greenenergyprojects/rpi-atmega324-modbus-x3-gateway/kicad/dist/rpi-atmega324-modbus-x3-gateway_image-bottom.png

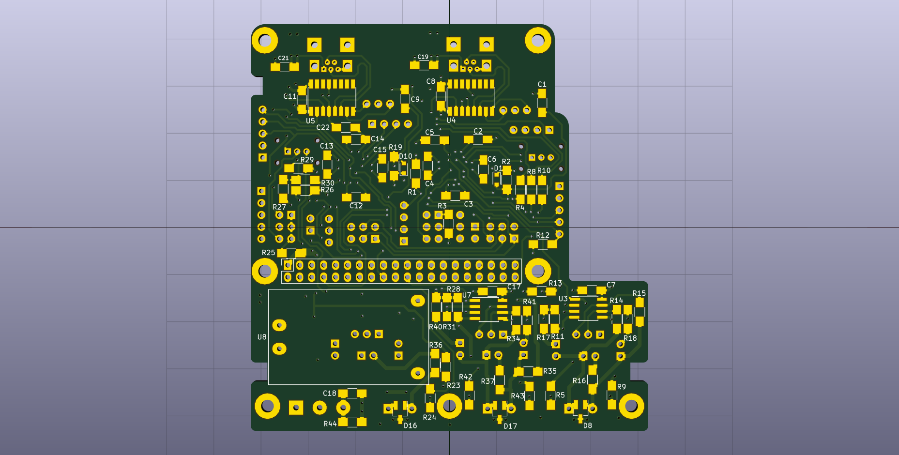
kicad/dist/rpi-atmega324-modbus-x3-gateway_image-bottom.png
