greenenergyprojects/rpi-atmega324-modbus-x3-gateway/kicad/dist/rpi-atmega324-modbus-x3-gateway_image-top.png

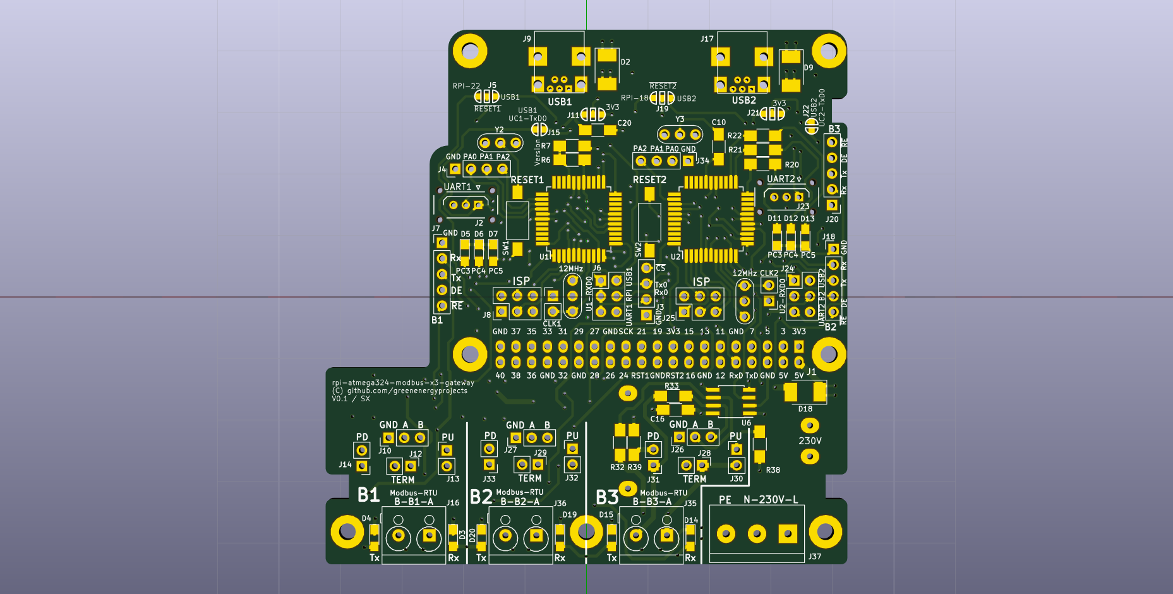
kicad/dist/rpi-atmega324-modbus-x3-gateway_image-top.png
