greenenergyprojects/rpi-atmega324-modbus-x3-gateway/kicad/dist/rpi-atmega324-modbus-x3-gateway_bom.ods

Source: | /work/sx/gep/rpi-atmega324-modbus-x3-gateway/kicad/rpi-atmega324-modbus-x3-gateway.sch
Date: | Do 20 Sep 2018 05:27:58 CEST
Tool: | Eeschema 4.0.7-e2-6376~61~ubuntu18.04.1
Component Count: | 139
Ref | Value | Footprint | Datasheet | Manufacturer | Vendor
C1 | 100n | Capacitors_SMD:C_1206_HandSoldering
C2 | 100n | Capacitors_SMD:C_1206_HandSoldering
C3 | 100n | Capacitors_SMD:C_1206_HandSoldering
C4 | 100n | Capacitors_SMD:C_1206_HandSoldering
C5 | 100n | Capacitors_SMD:C_1206_HandSoldering
C6 | 100n | Capacitors_SMD:C_1206_HandSoldering
C7 | 100n | Capacitors_SMD:C_1206_HandSoldering
C8 | 100n | Capacitors_SMD:C_1206_HandSoldering
C9 | 100n | Capacitors_SMD:C_1206_HandSoldering
C10 | 100n | Capacitors_SMD:C_1206_HandSoldering
C11 | 100n | Capacitors_SMD:C_1206_HandSoldering
C12 | 100n | Capacitors_SMD:C_1206_HandSoldering
C13 | 100n | Capacitors_SMD:C_1206_HandSoldering
C14 | 100n | Capacitors_SMD:C_1206_HandSoldering
C15 | 100n | Capacitors_SMD:C_1206_HandSoldering
C16 | 100n | Capacitors_SMD:C_1206_HandSoldering
C17 | 100n | Capacitors_SMD:C_1206_HandSoldering
C18 | 100n | Capacitors_SMD:C_1206_HandSoldering
C19 | 100n | Capacitors_SMD:C_1206_HandSoldering
C20 | 100n | Capacitors_SMD:C_1206_HandSoldering
C21 | 100n | Capacitors_SMD:C_1206_HandSoldering
C22 | 100n | Capacitors_SMD:C_1206_HandSoldering
D1 | D_Schottky | Diodes_SMD:D_0805
D2 | D_Schottky | Diodes_SMD:D_2114
D3 | LED | LEDs:LED_0805_HandSoldering
D4 | LED | LEDs:LED_0805_HandSoldering
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
U8 | HLK-5M05 | Project:HLK_5M05
Y1 | 12MHz | Crystals:Resonator-3pin_w7.0mm_h2.5mm
Y2 | 12MHz | Crystals:Resonator-3pin_w7.0mm_h2.5mm
Y3 | 12MHz | Crystals:Resonator-3pin_w7.0mm_h2.5mm
Y4 | 12MHz | Crystals:Resonator-3pin_w7.0mm_h2.5mm
