greenenergyprojects/rpi-atmega324-modbus-x3-gateway/kicad/dist/rpi-atmega324-modbus-x3-gateway_bom_pcb.pdf

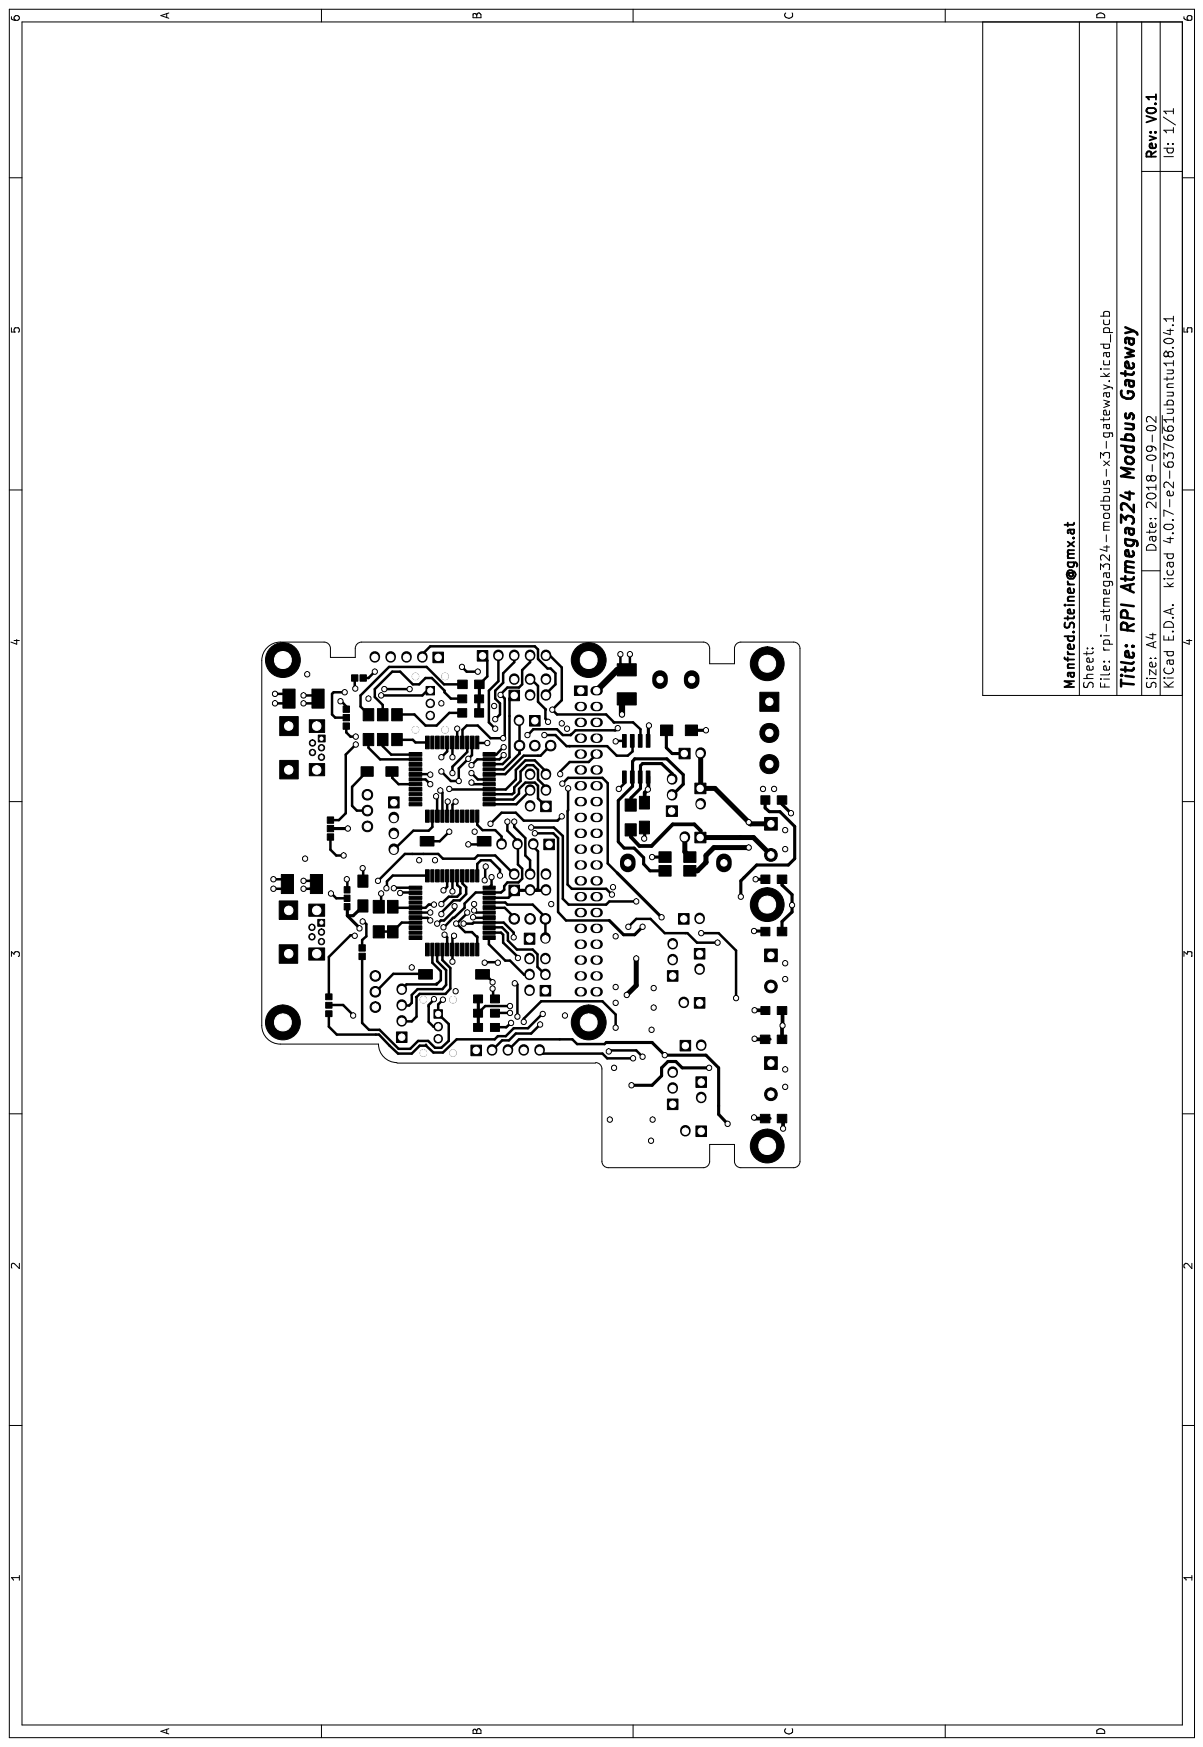
[picture p3: page 1]

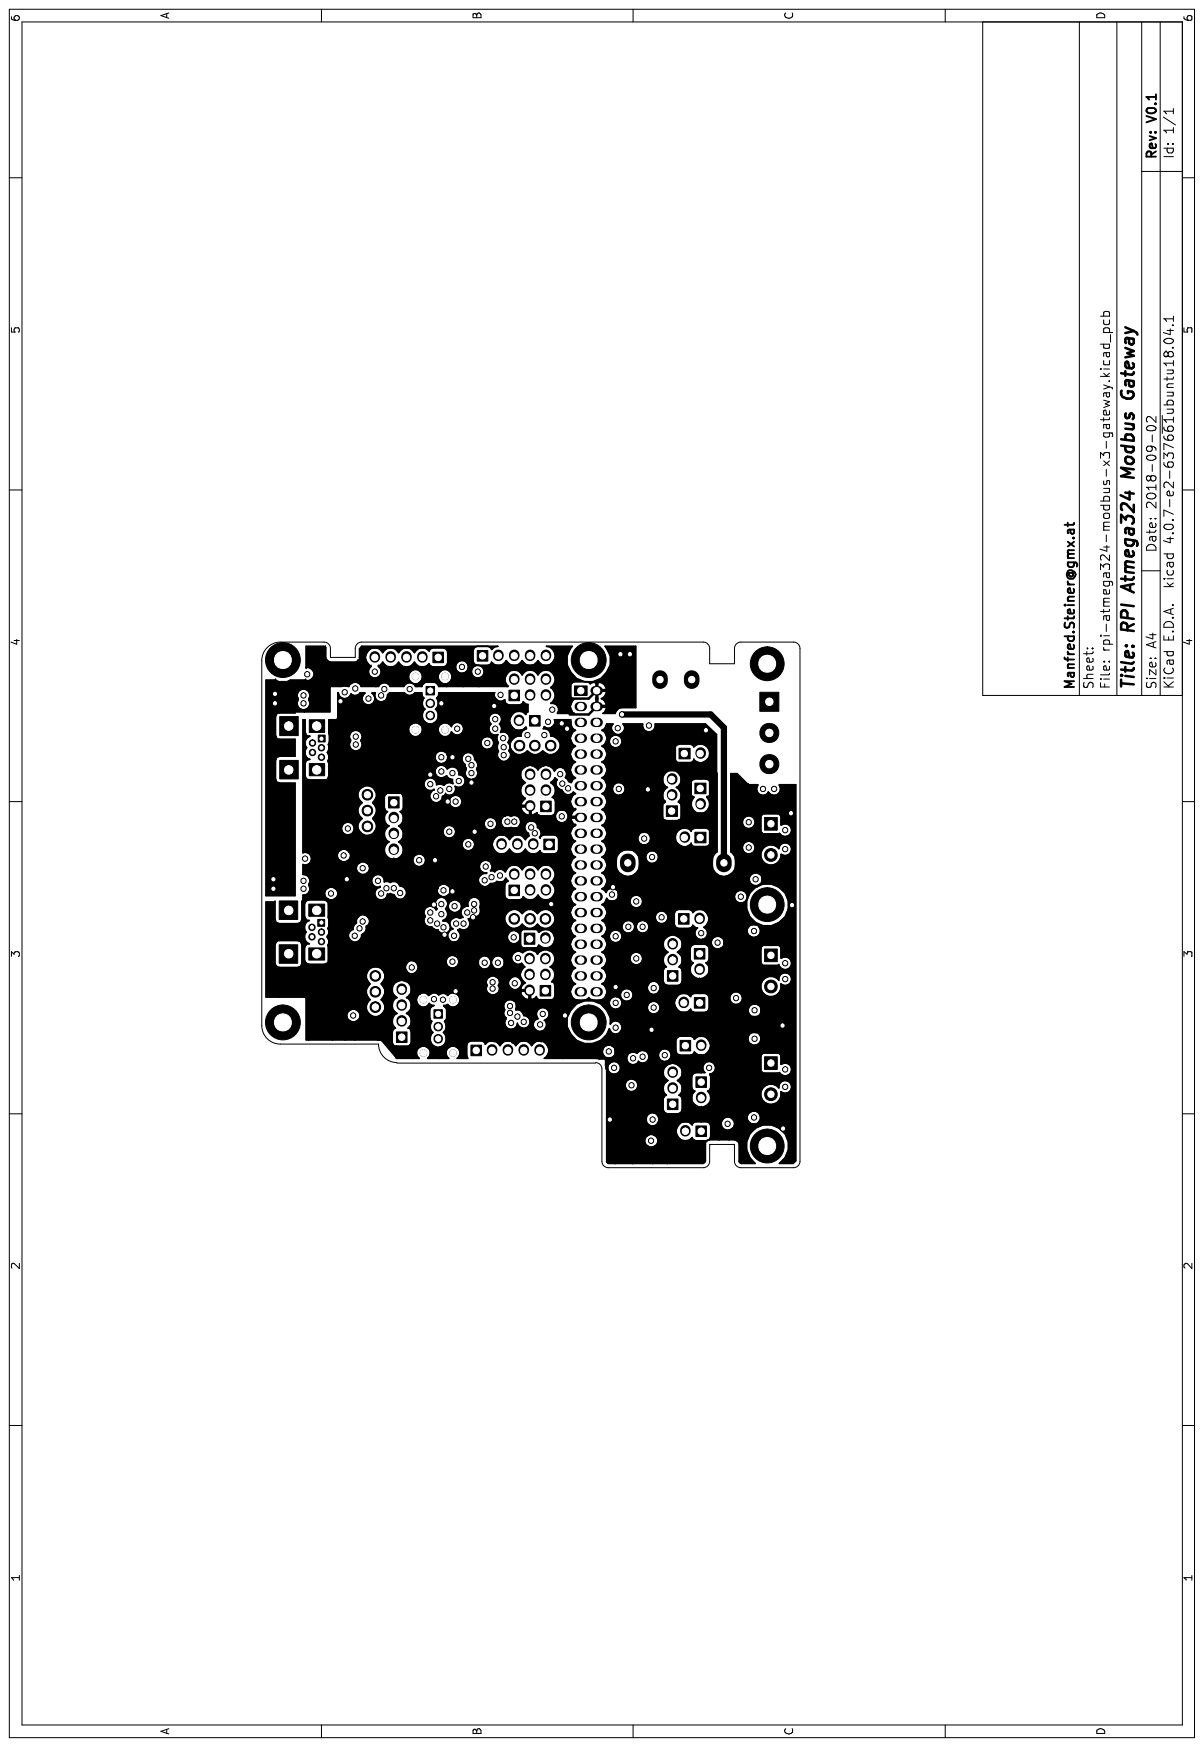
[picture p4: page 2]

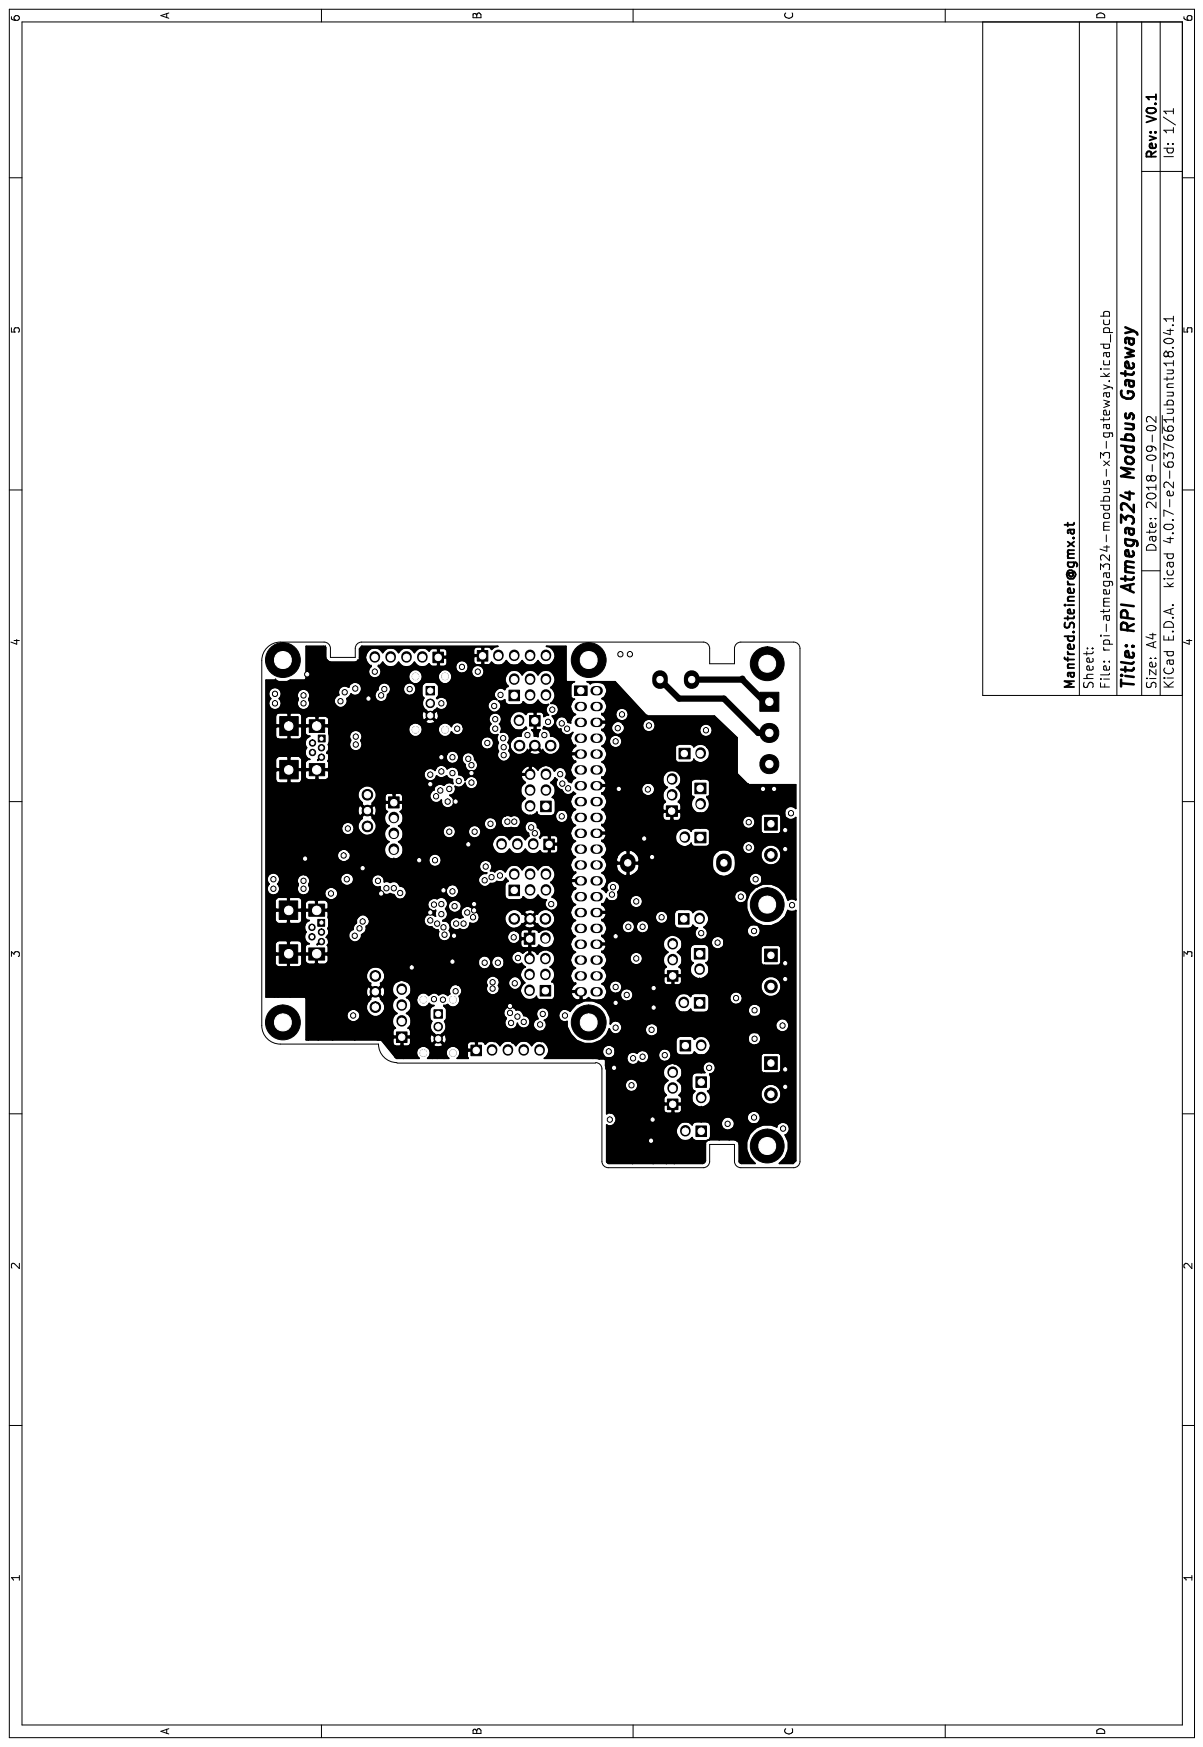
[picture p5: page 3]

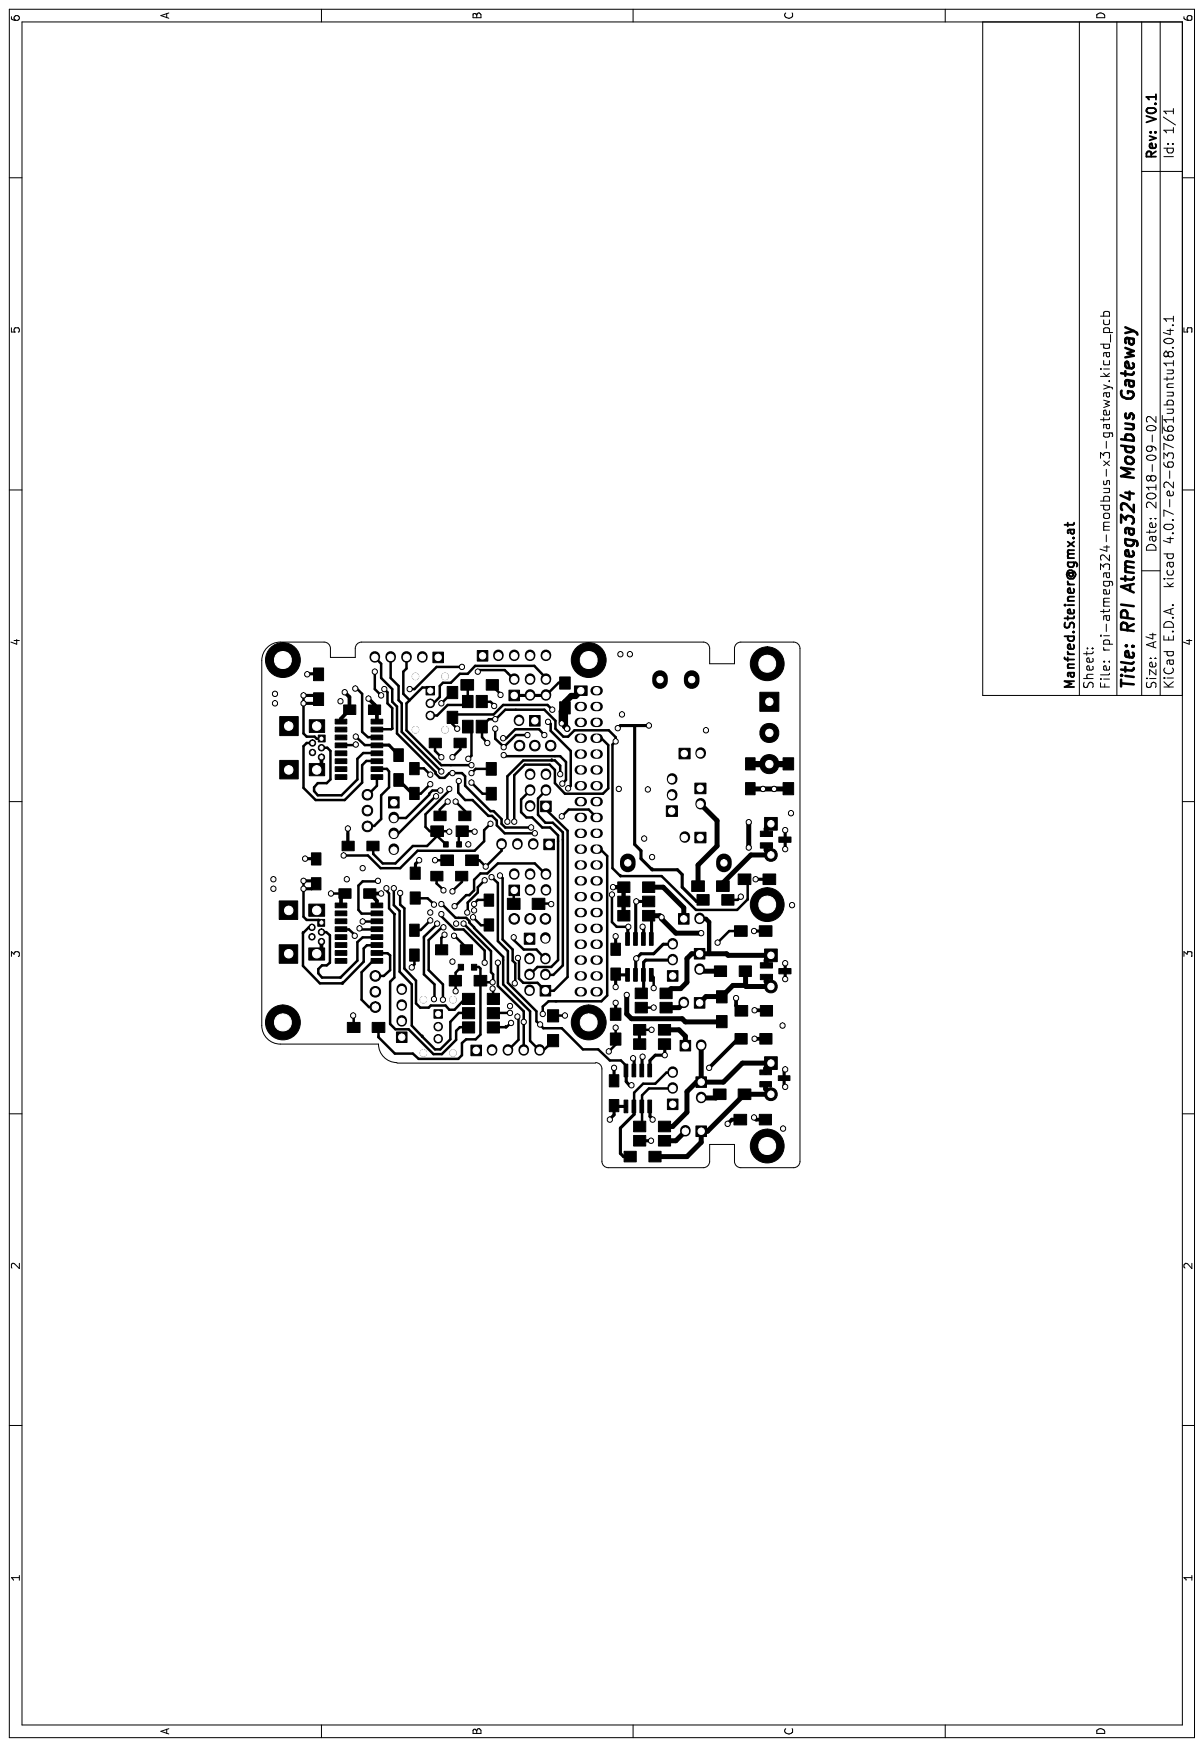
[picture p6: page 4]

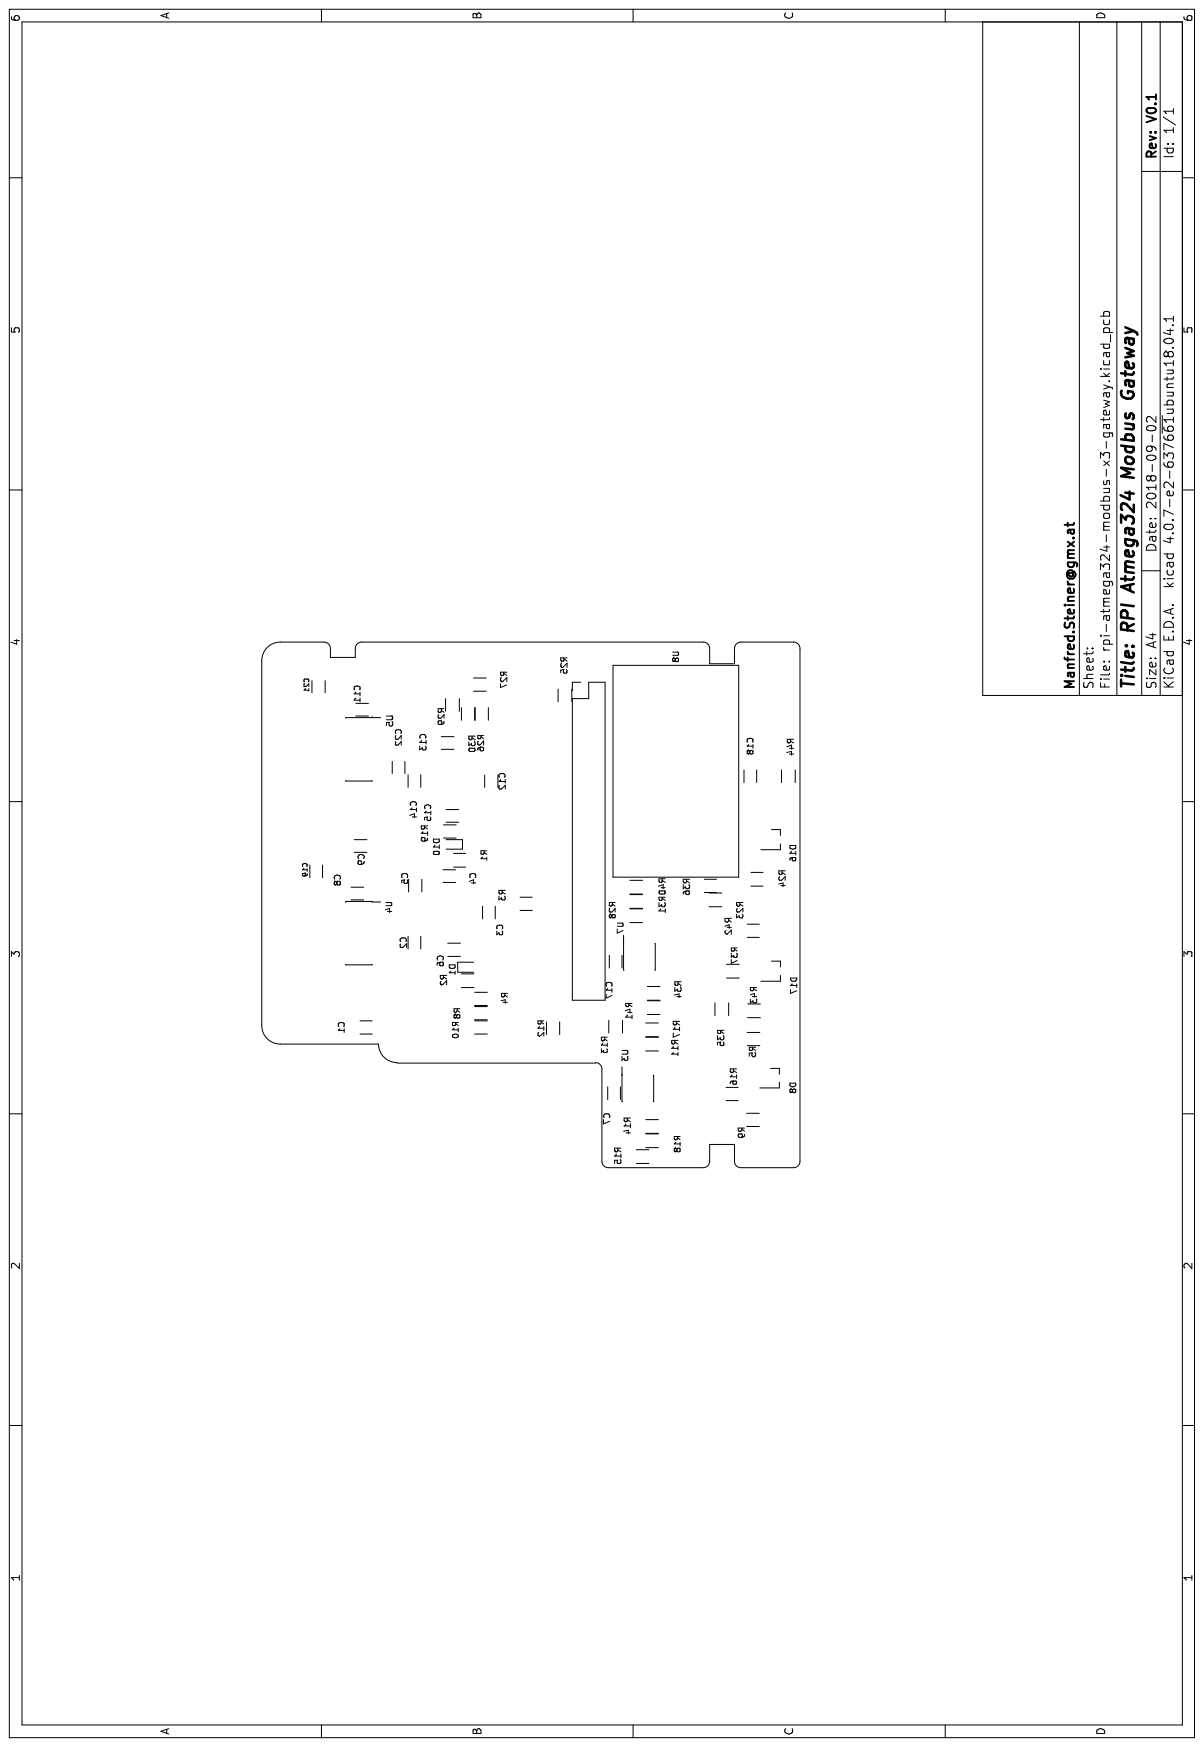
[picture p7: page 5]

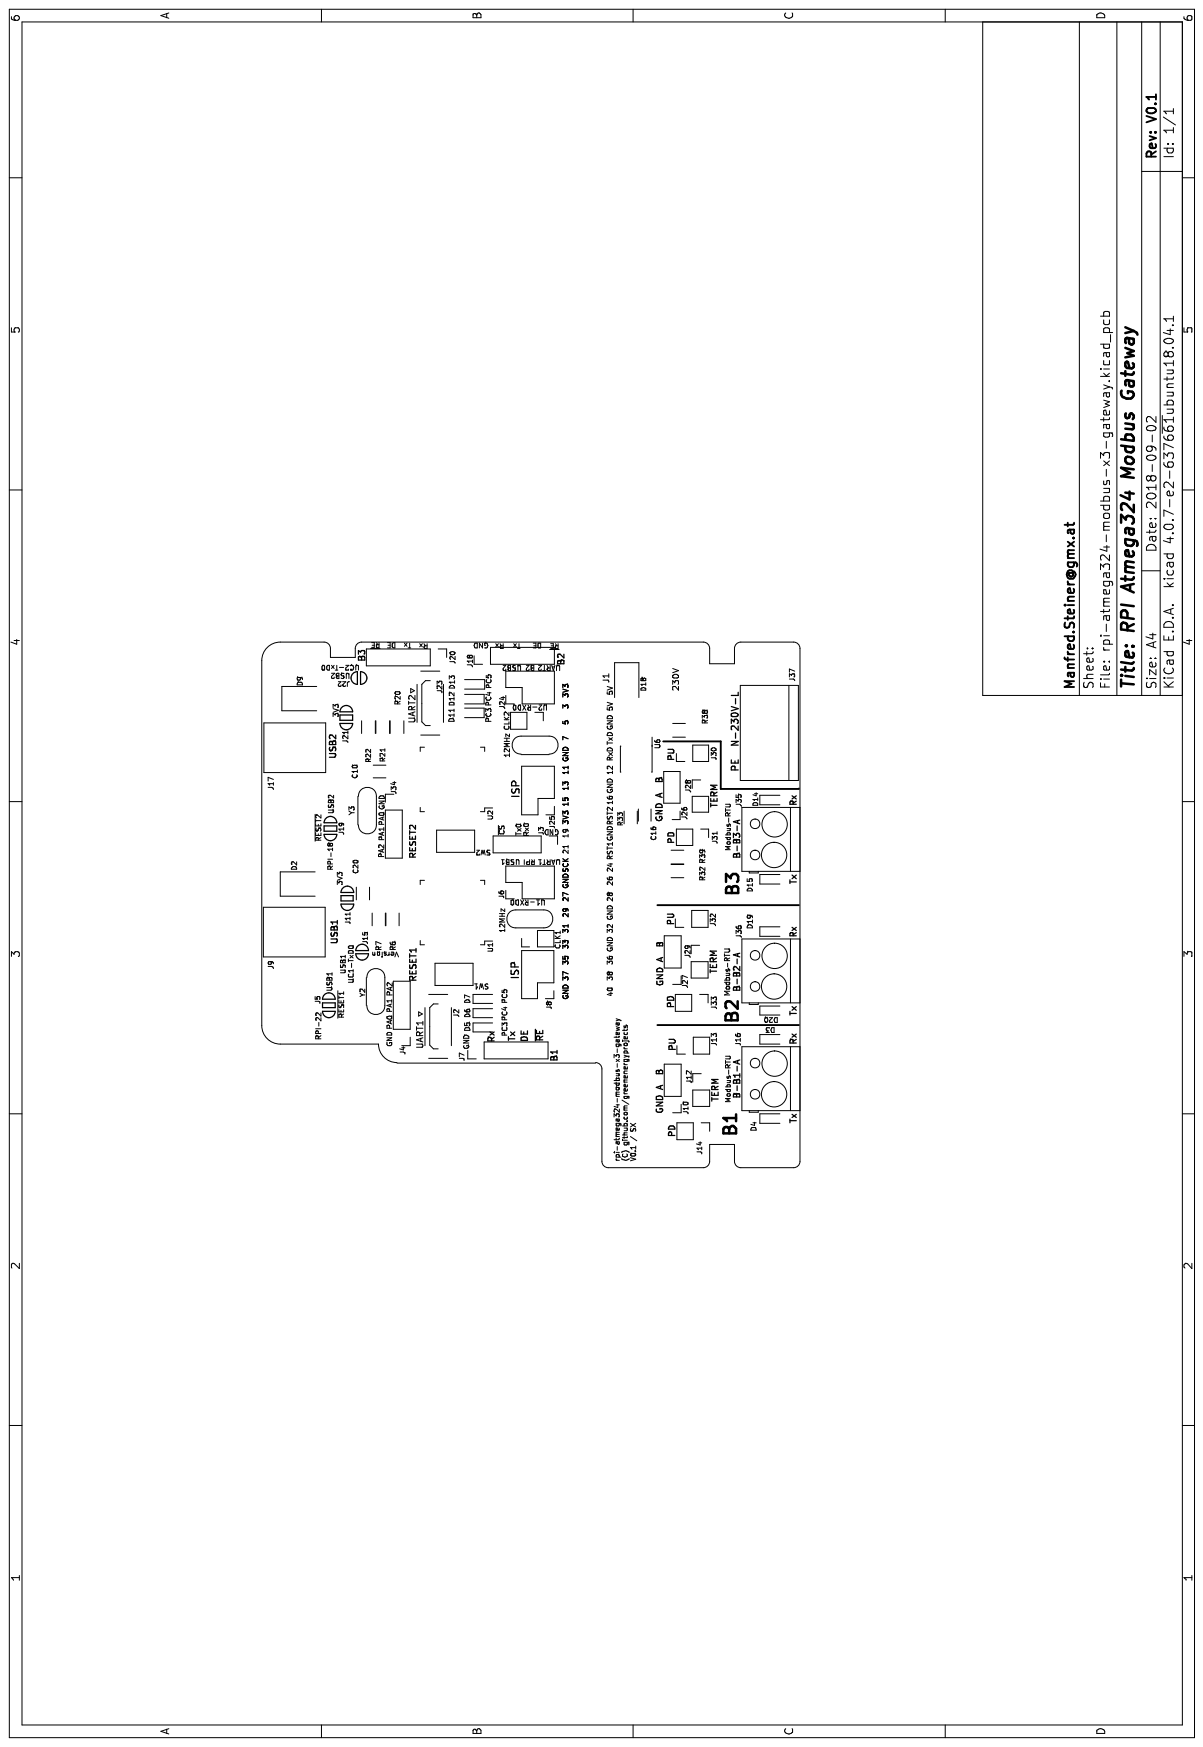
[picture p8: page 6]

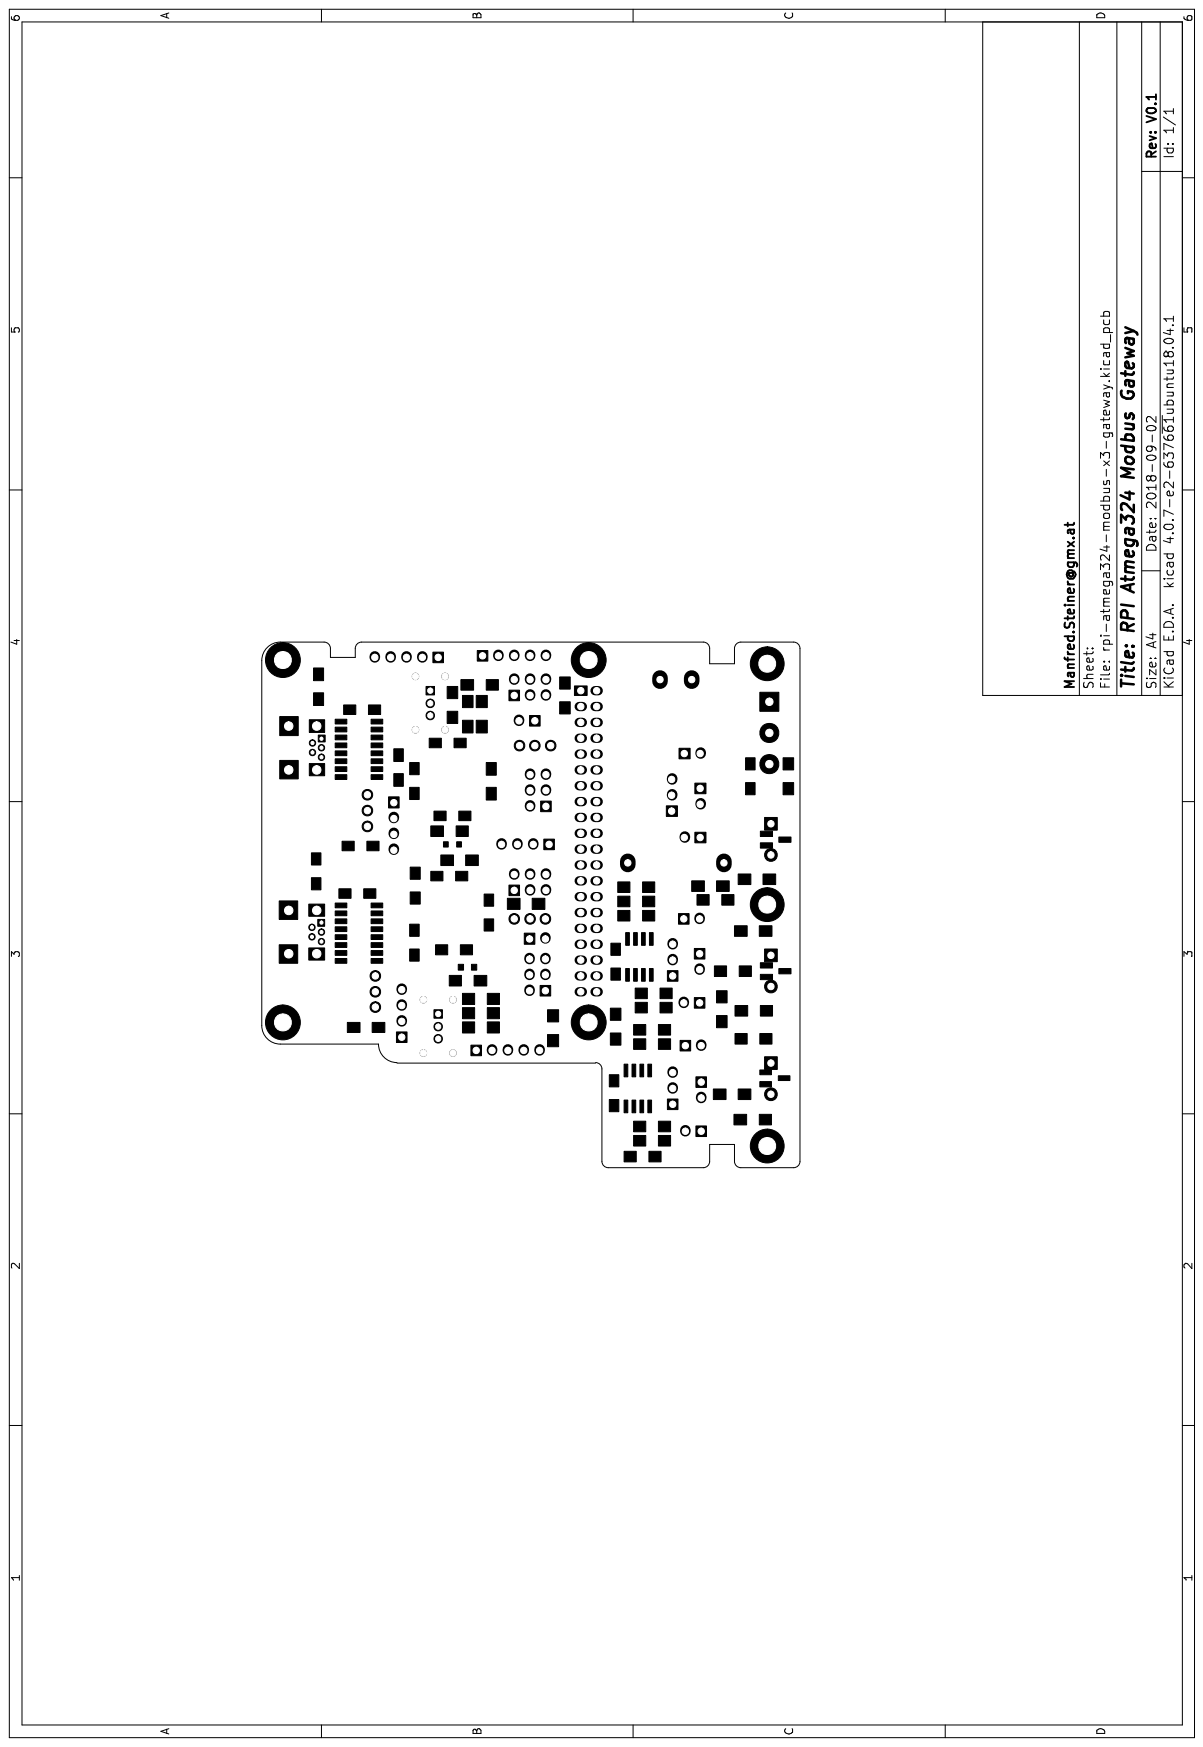
[picture p9: page 7]

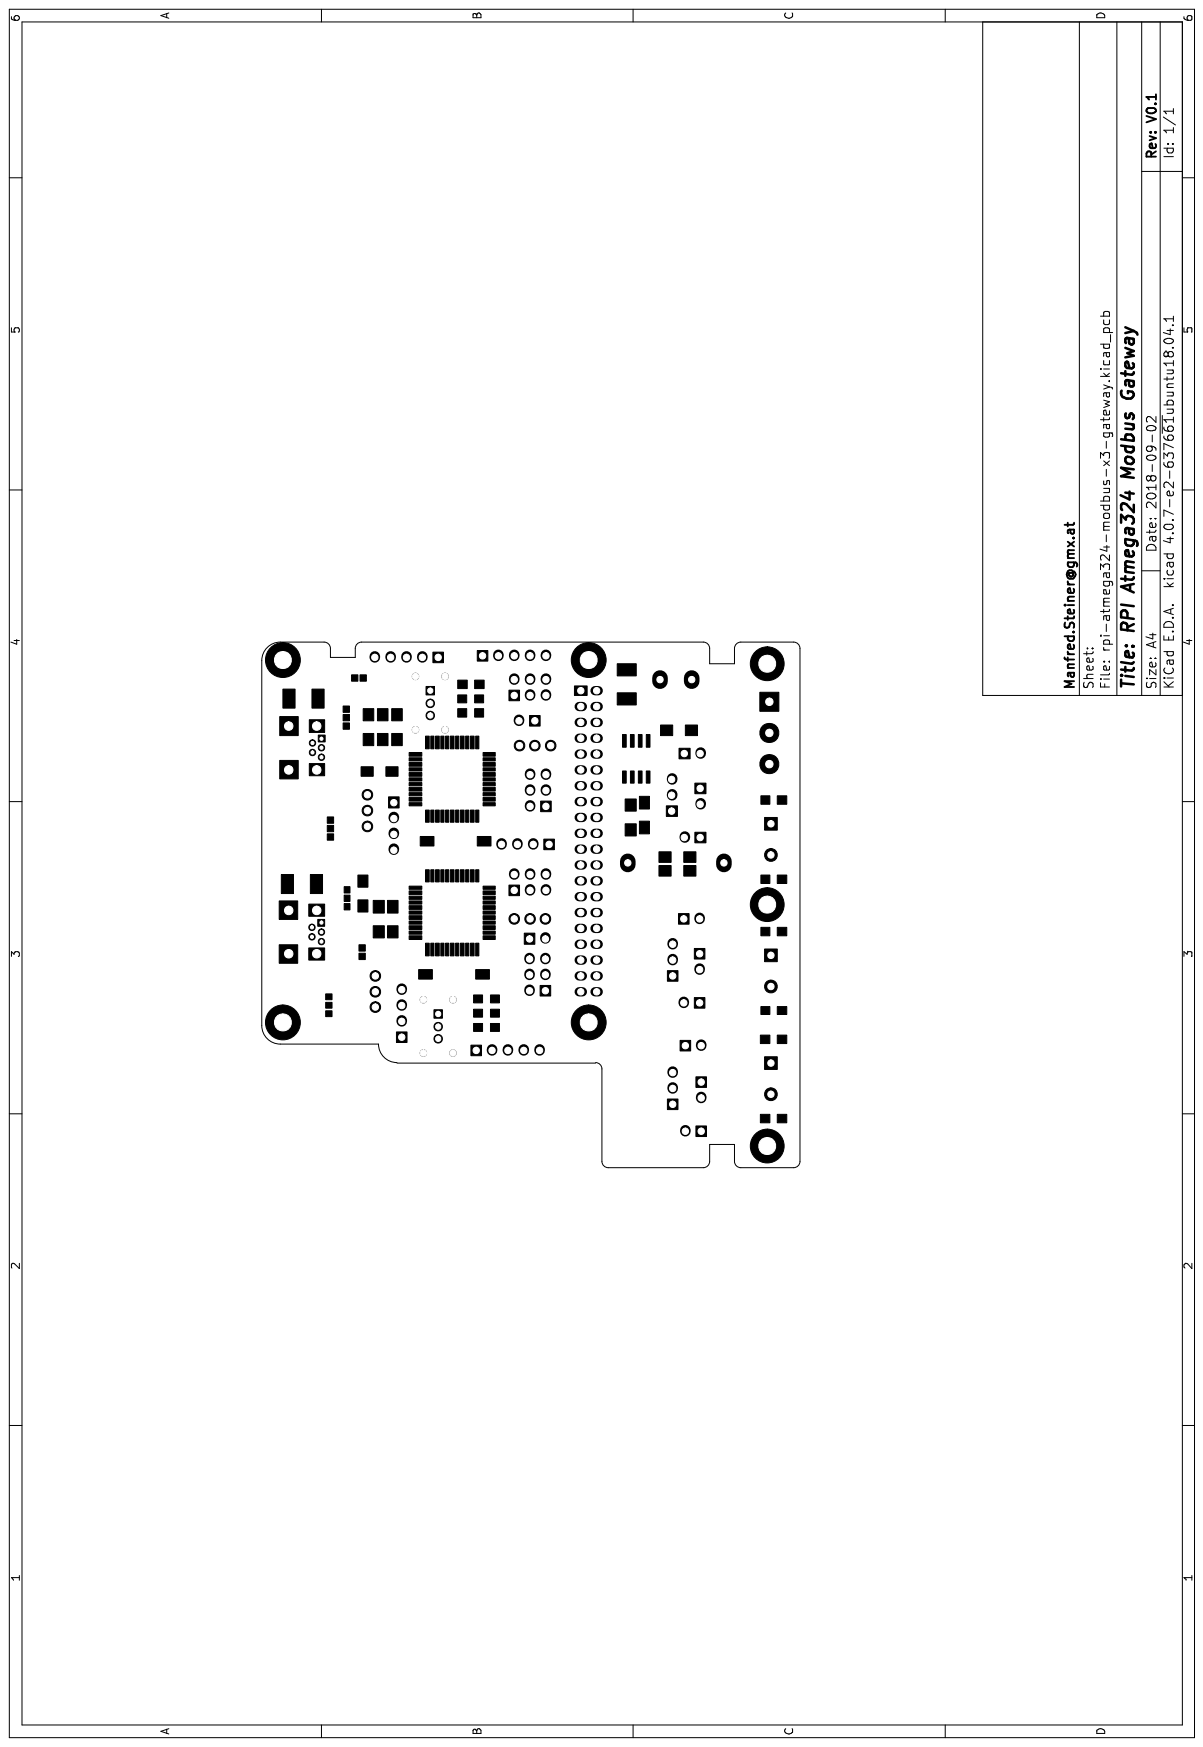
[picture p10: page 8]

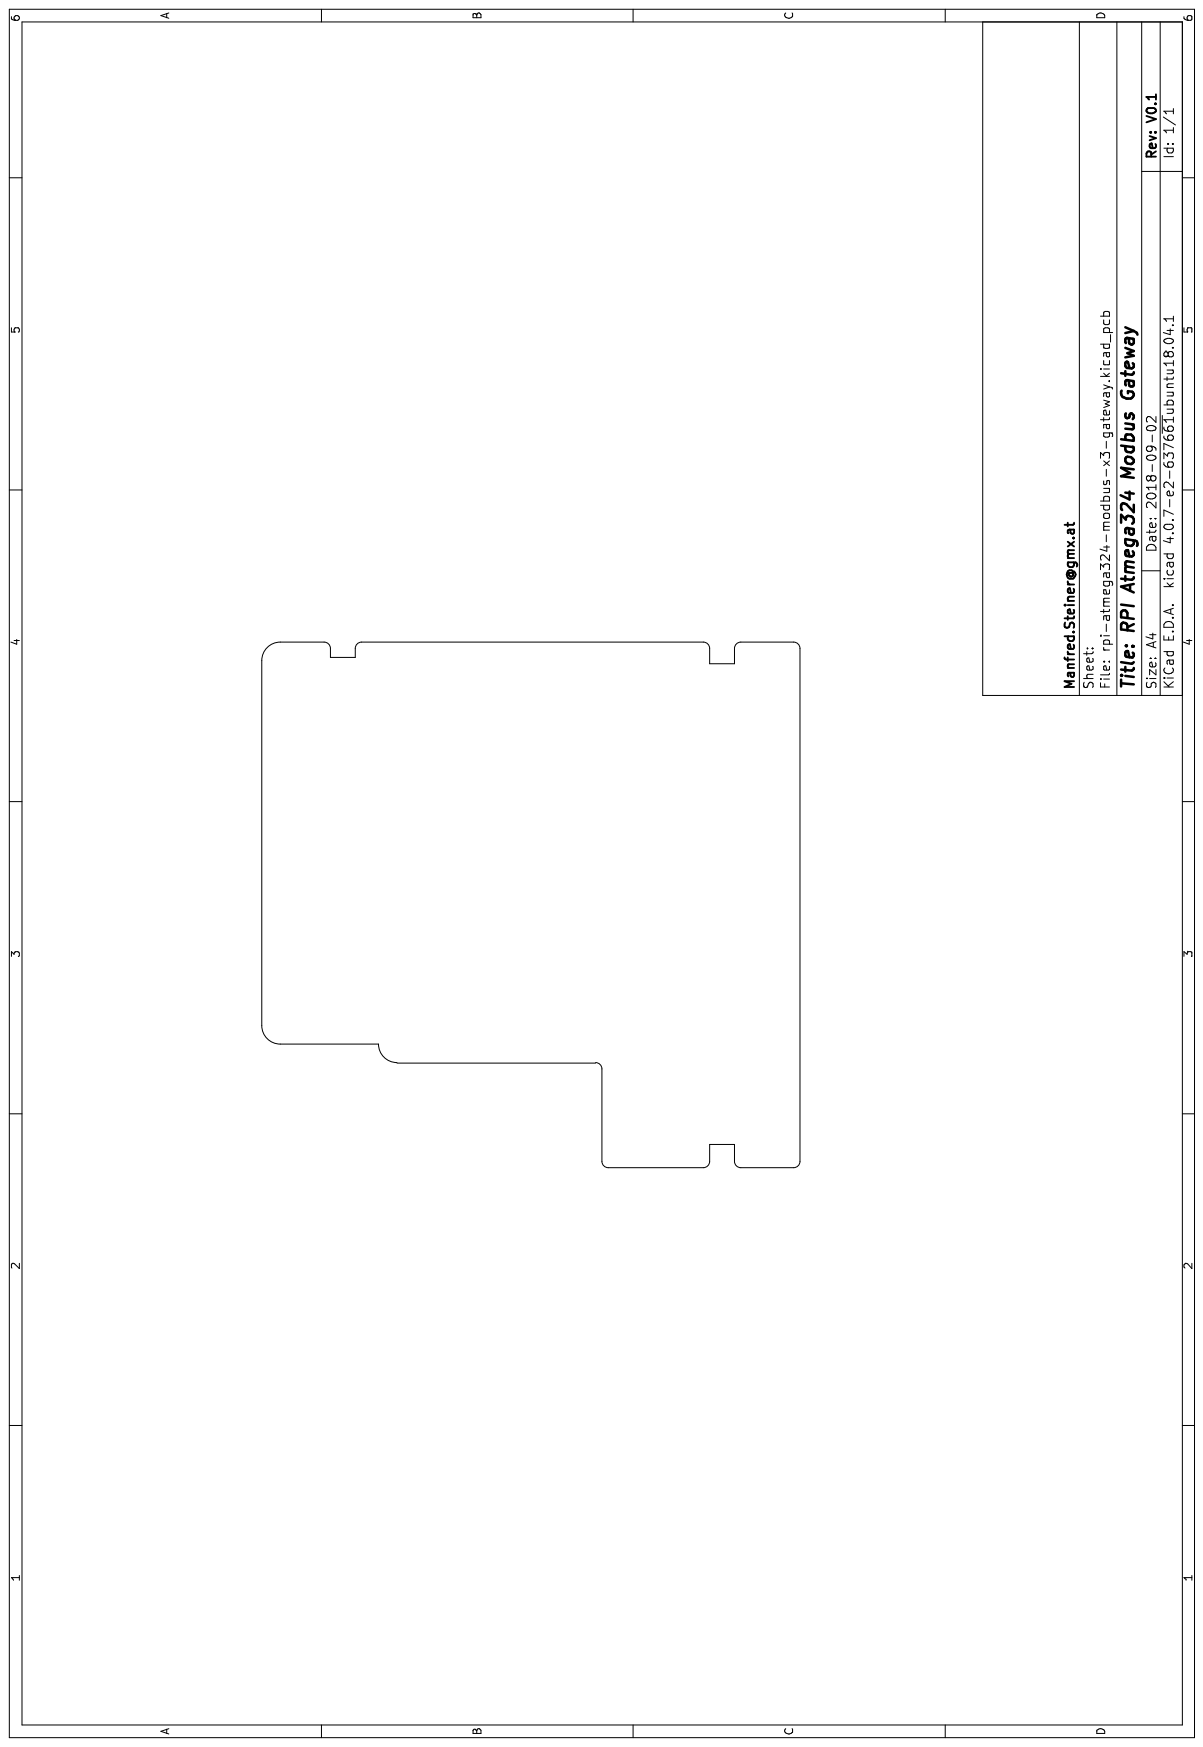
[picture p11: page 9]
