greenenergyprojects/rpi-atmega324-modbus-x3-gateway/kicad/dist/rpi-atmega324-modbus-x3-gateway_schematic-bw.pdf

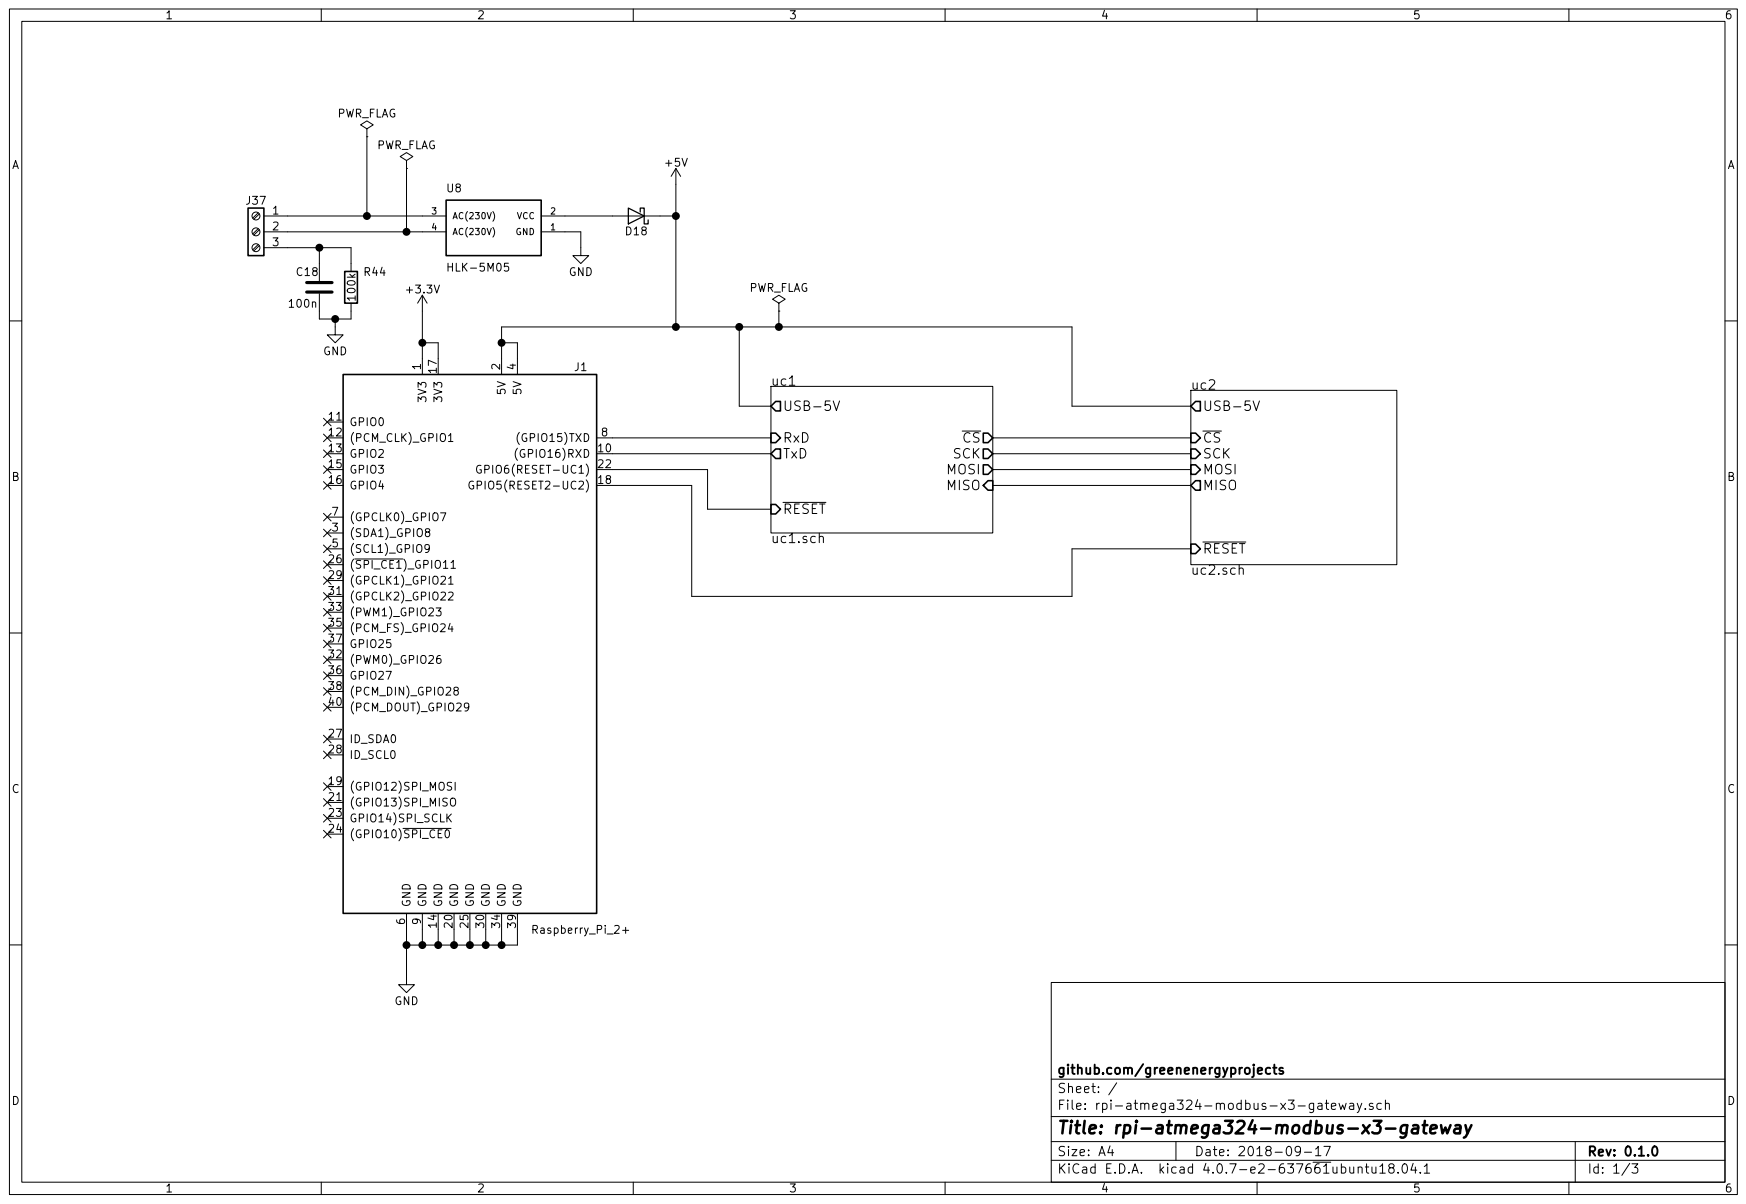
[picture p12: page 1]

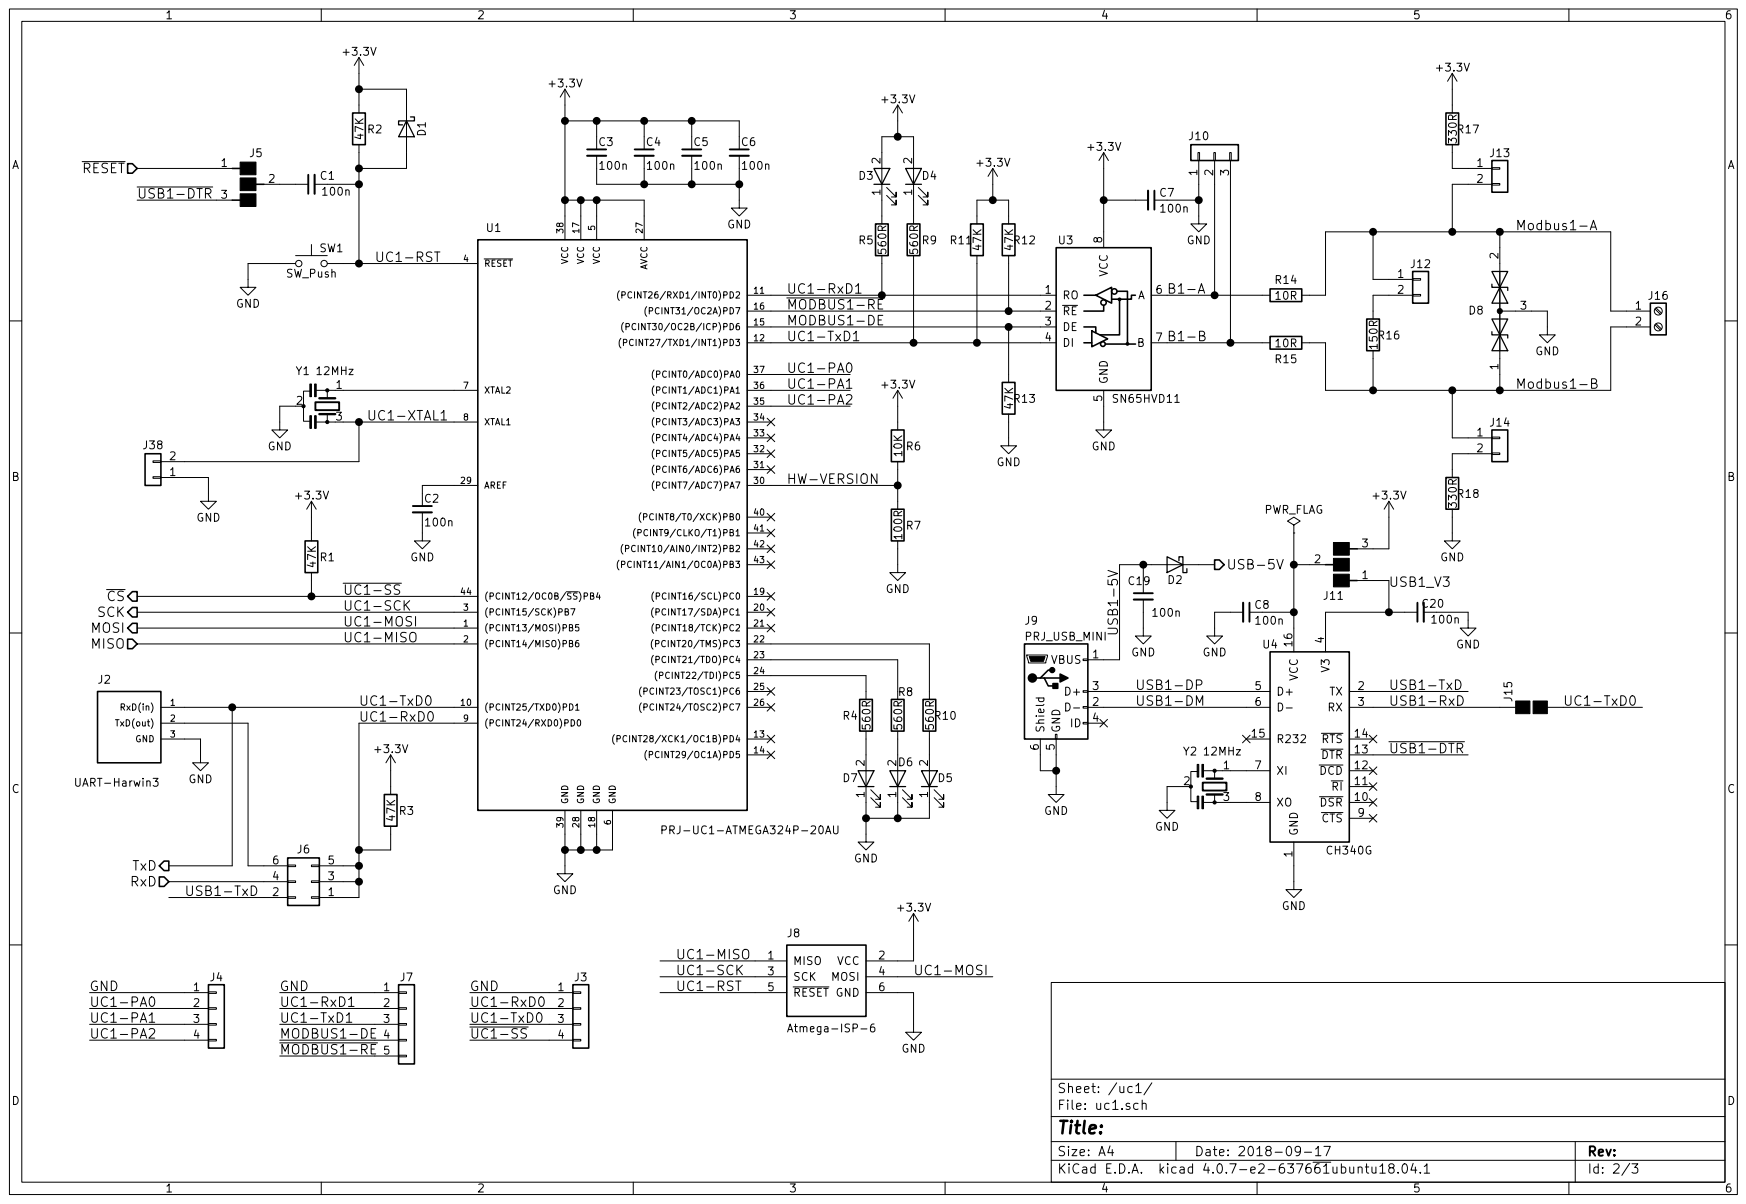
[picture p13: page 2]

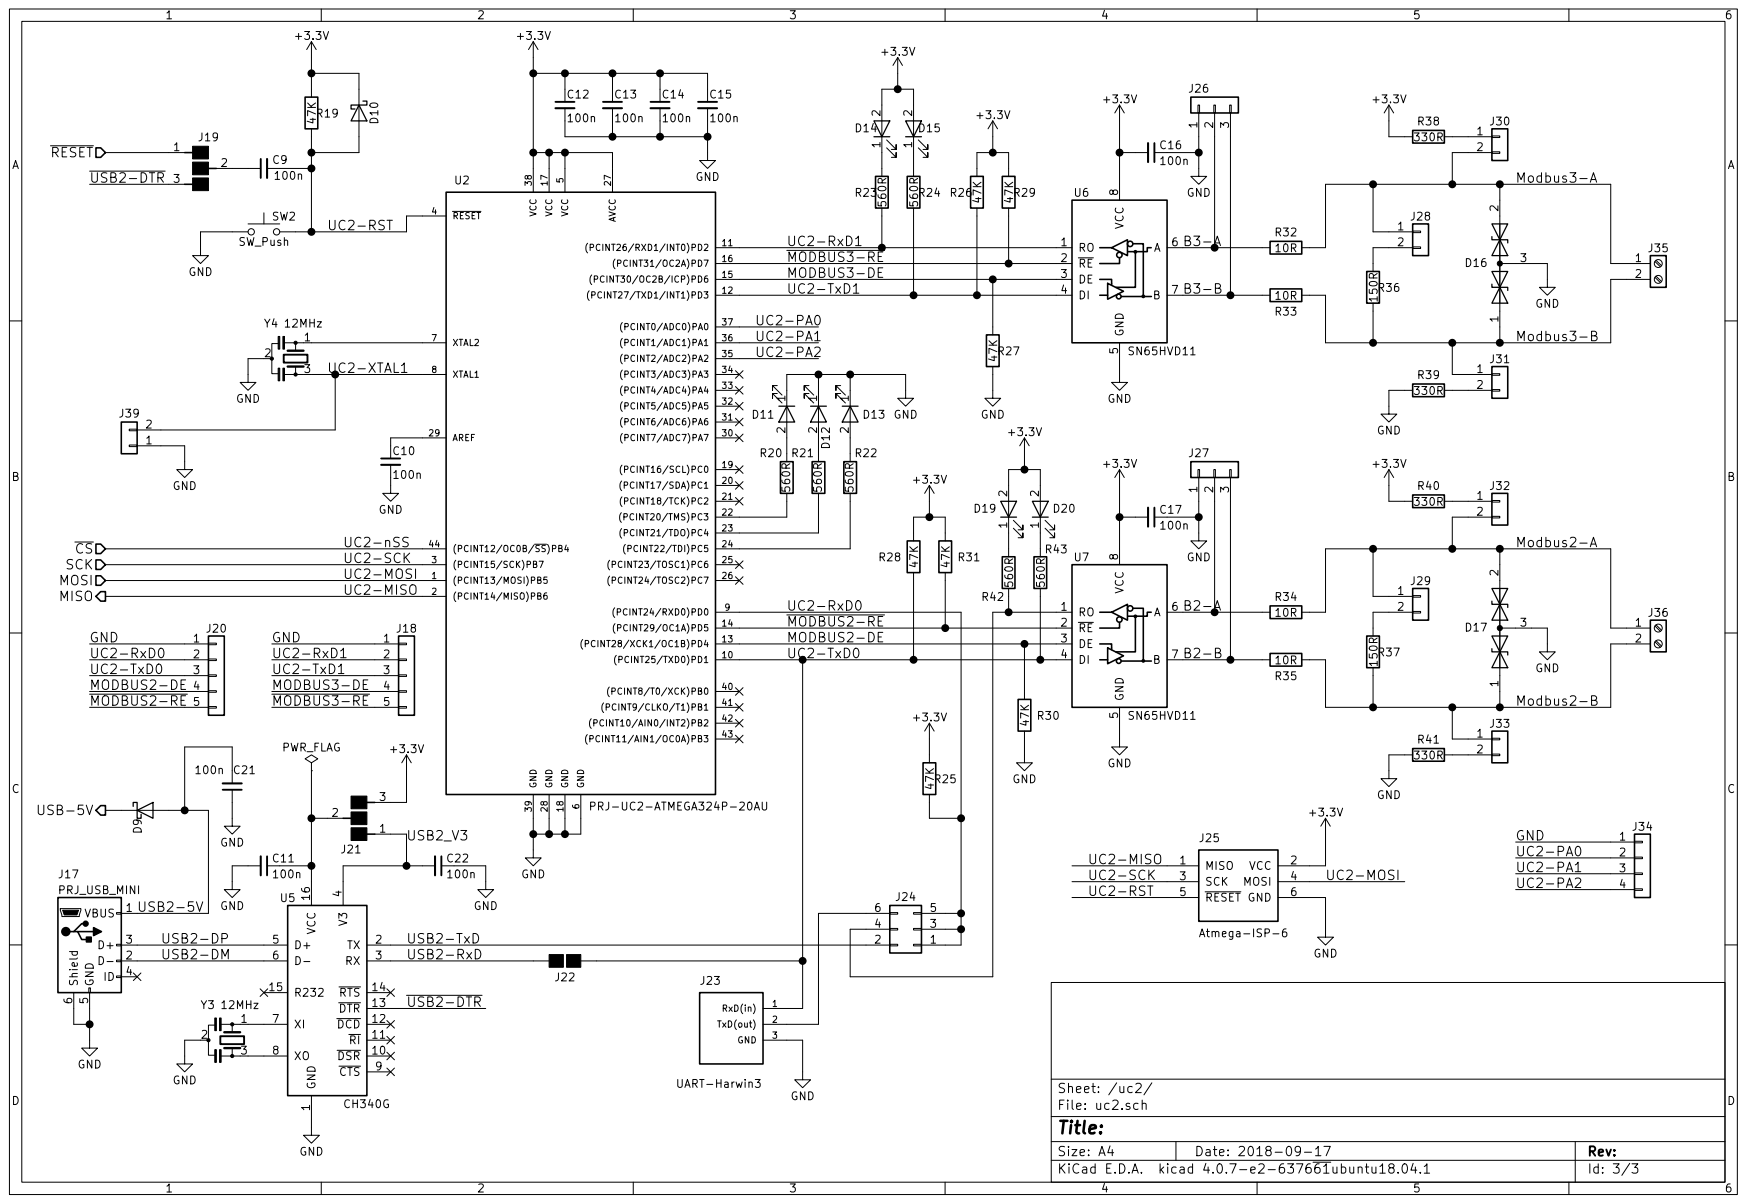
[picture p14: page 3]
