greenenergyprojects/rpi-atmega324-modbus-x3-gateway/kicad/dist/rpi-atmega324-modbus-x3-gateway_schematic.pdf

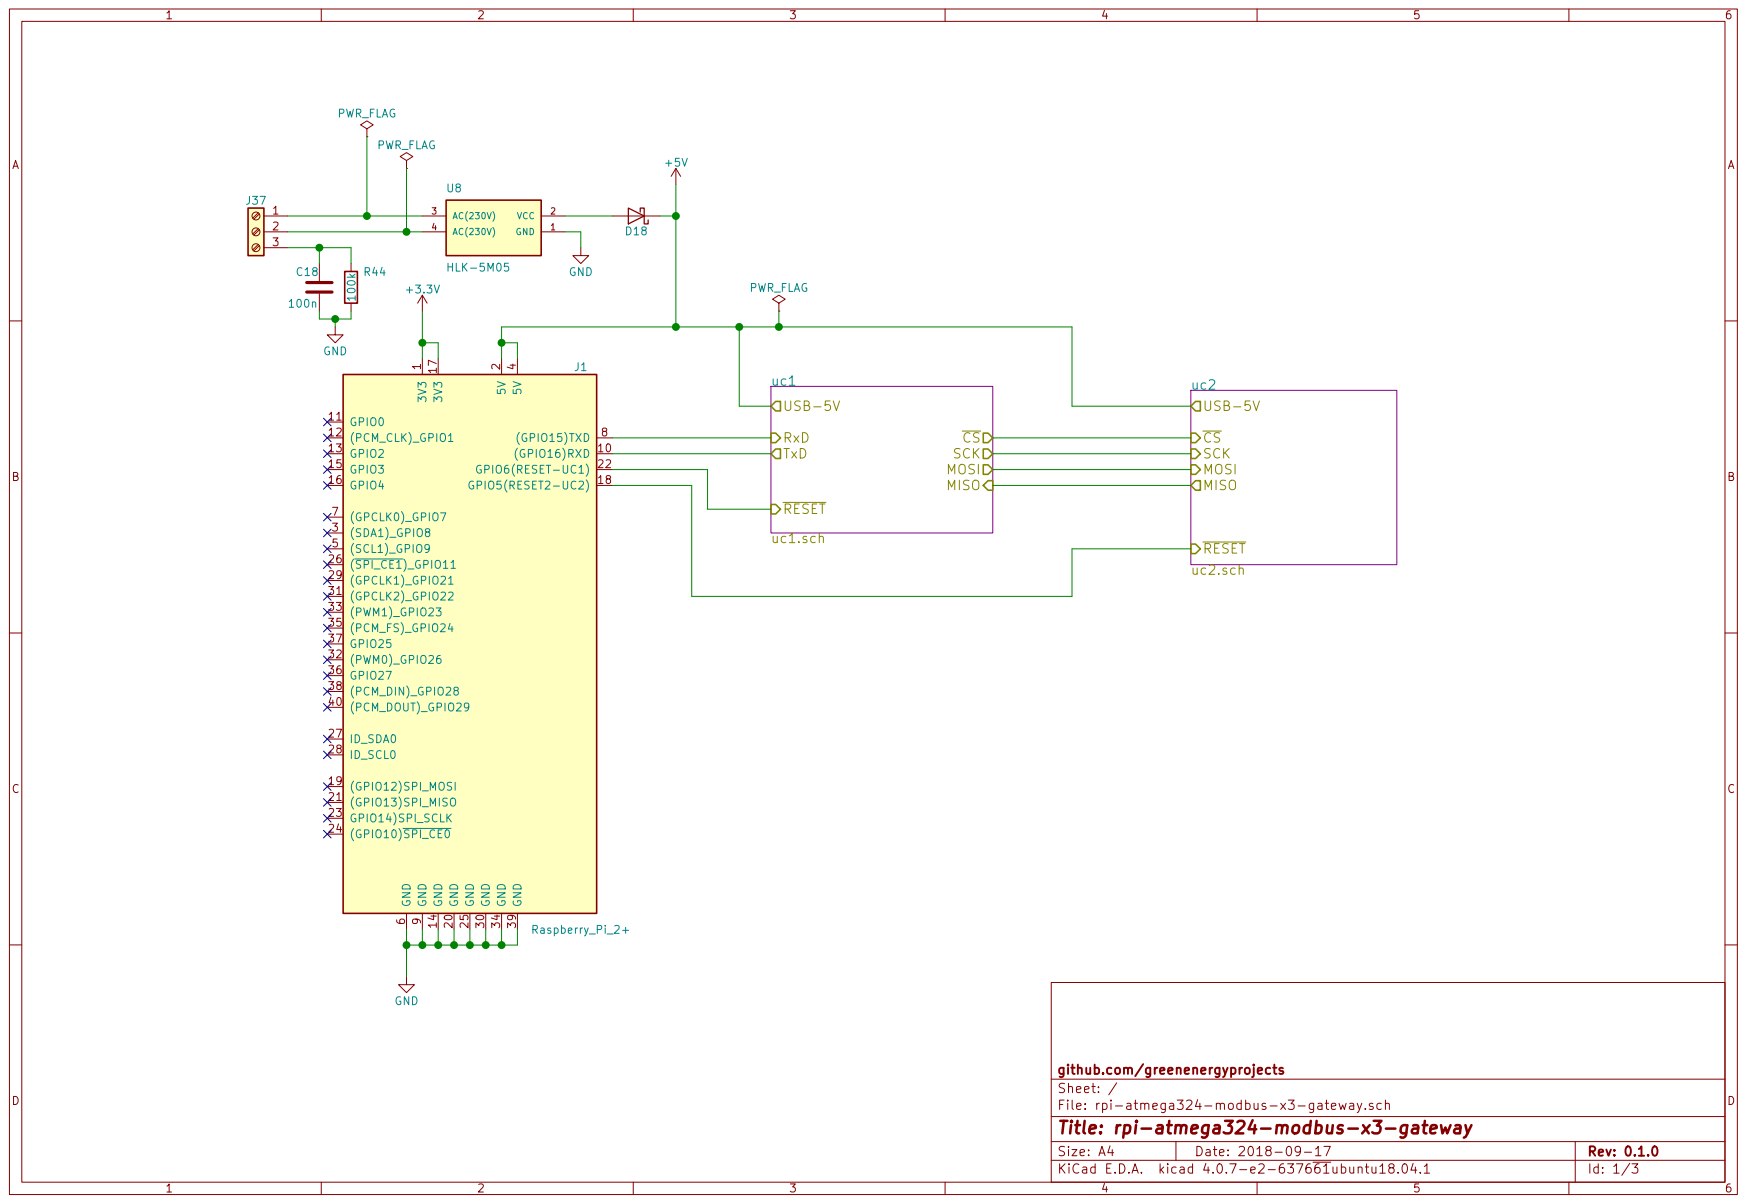
[picture p15: page 1]

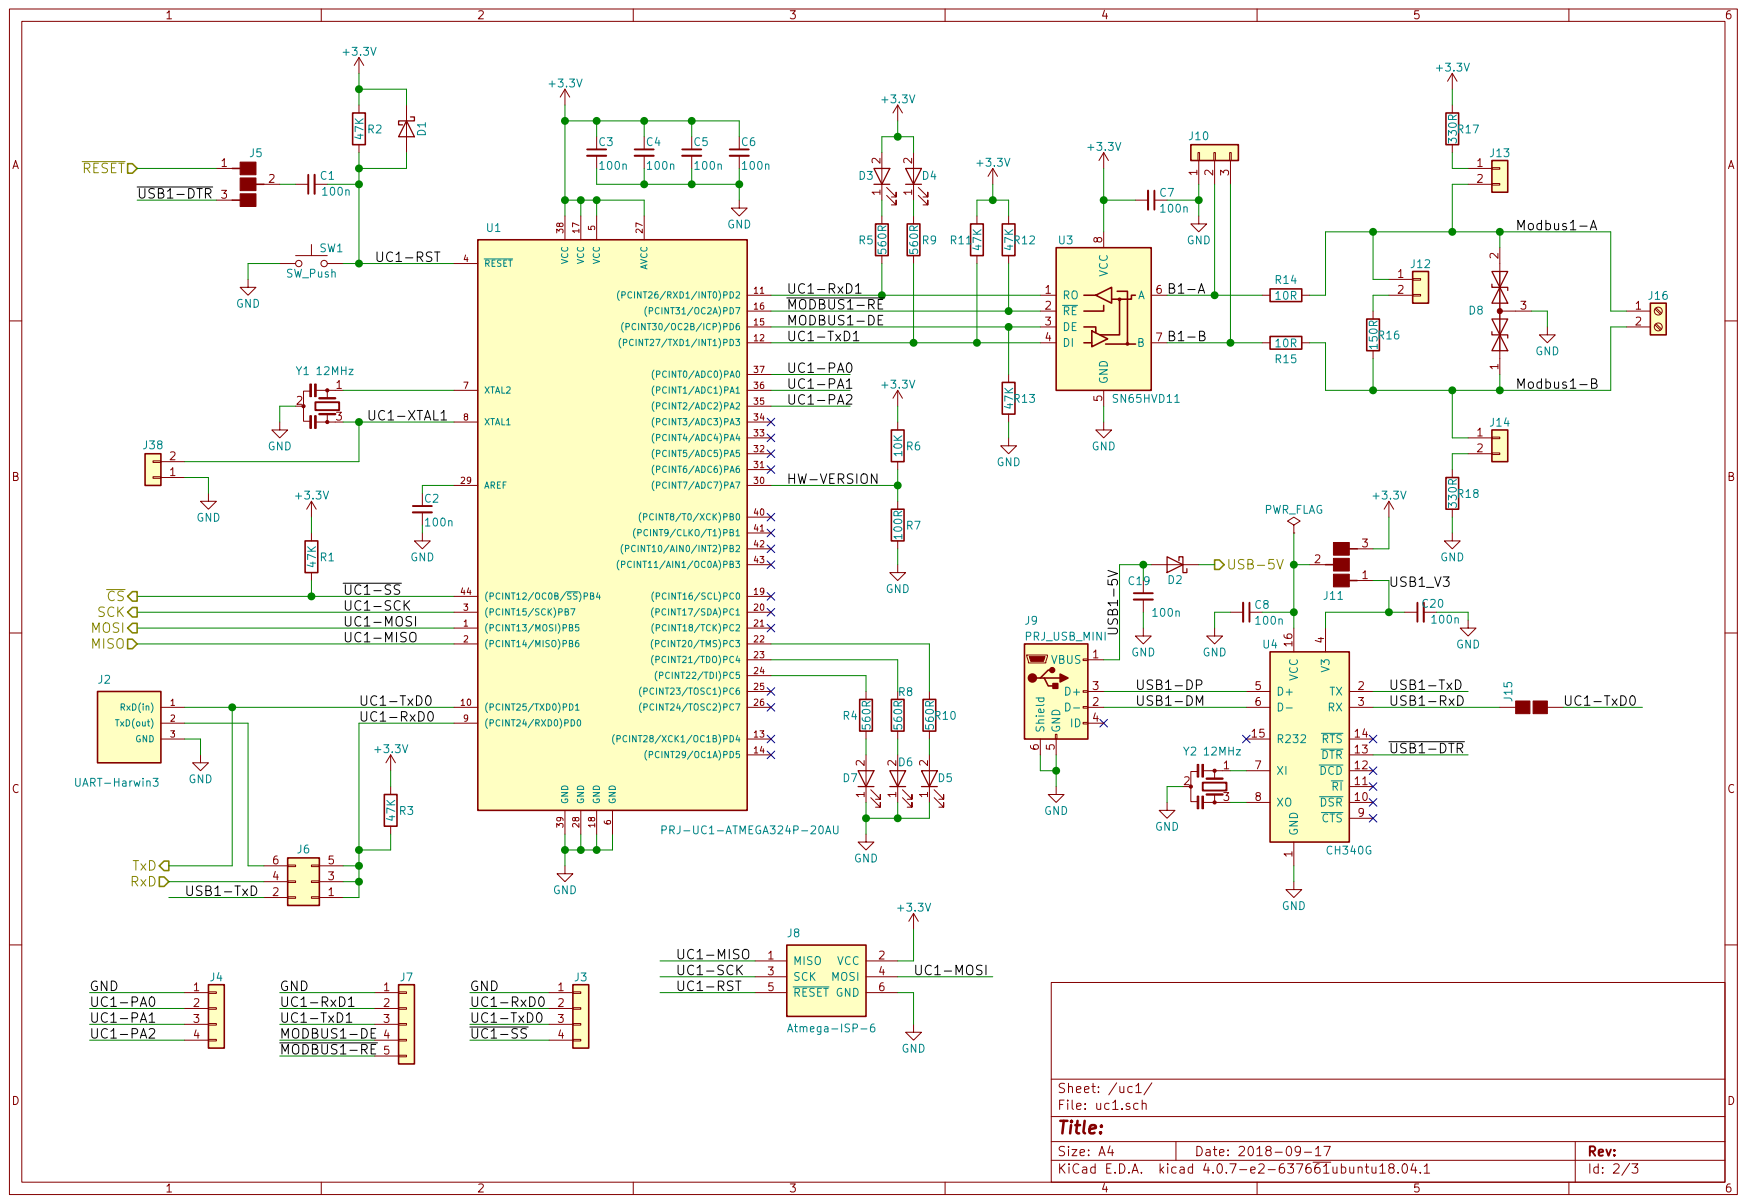
[picture p16: page 2]

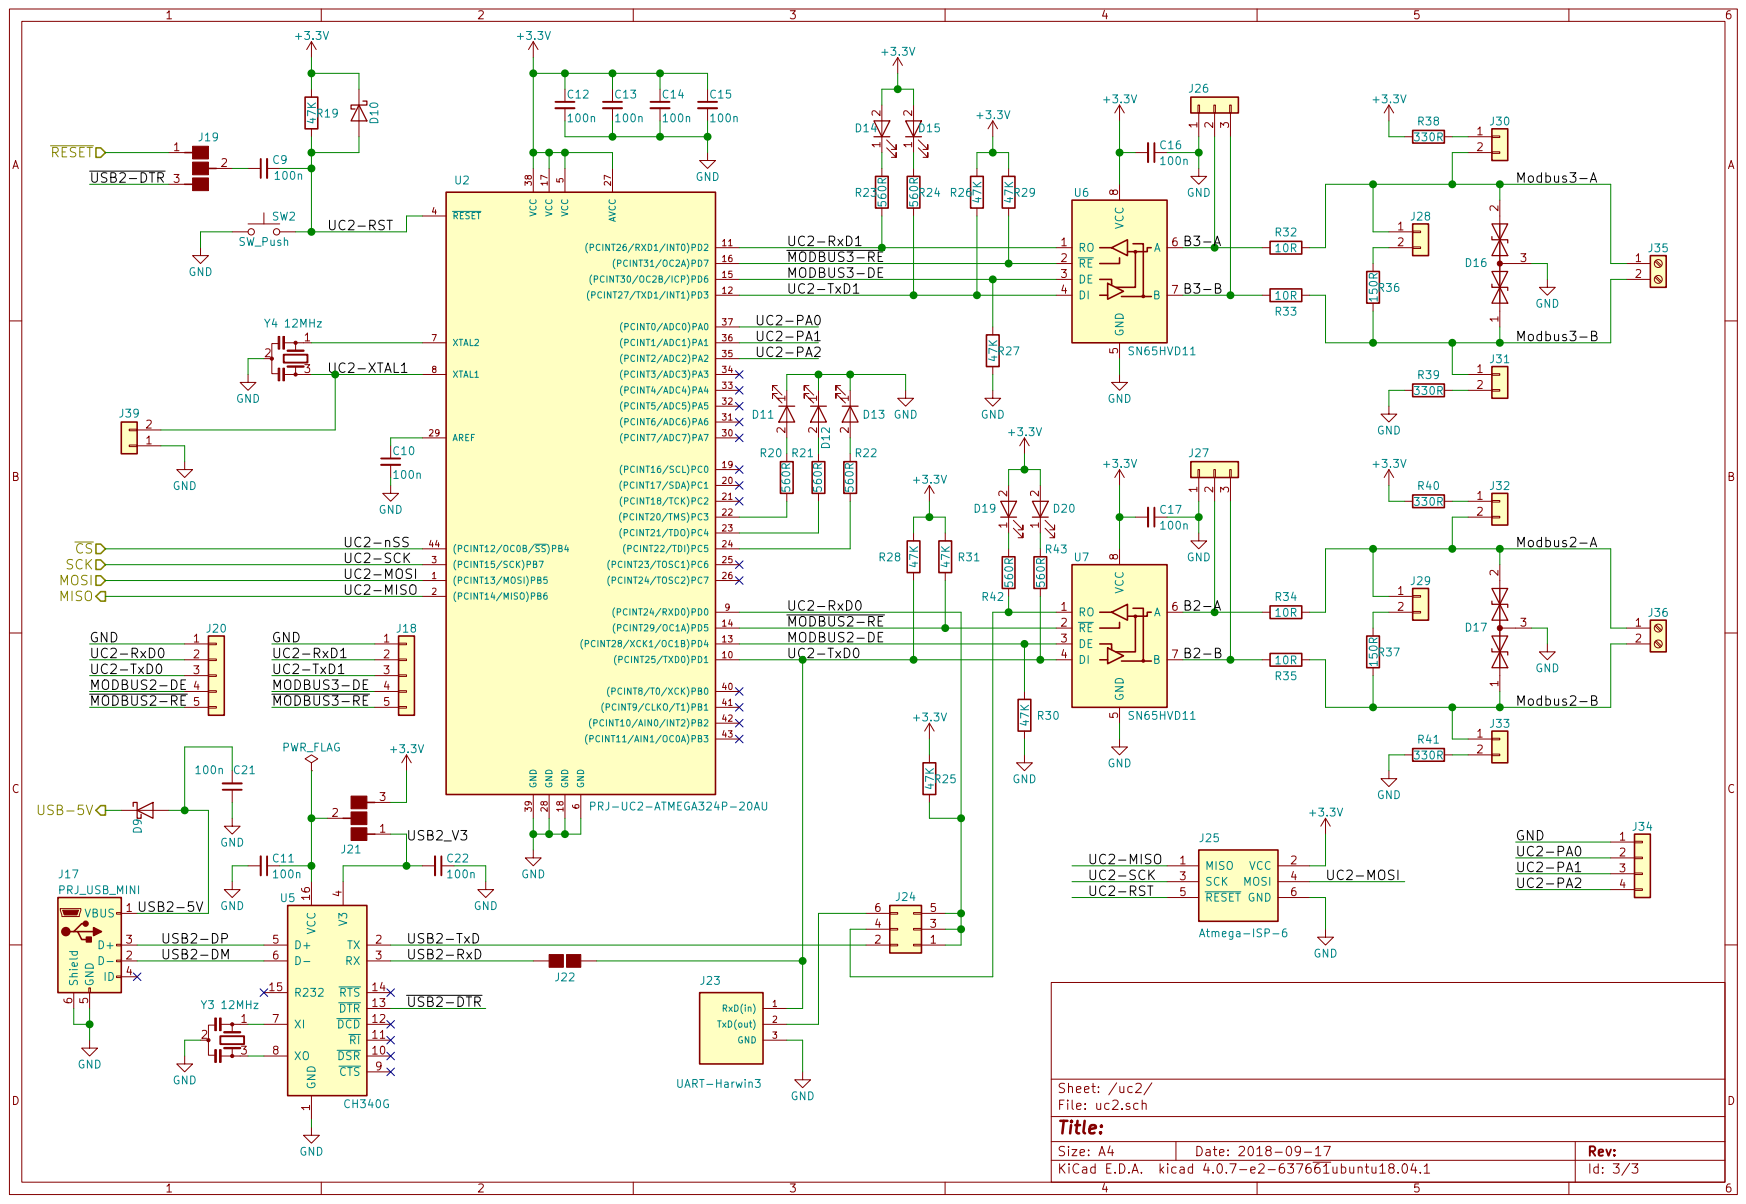
[picture p17: page 3]
