greenenergyprojects/rpi-atmega324-modbus-x3-gateway/kicad/rpi-atmega324-modbus-x3-gateway.kicad_pcb

## KiCad design kicad/rpi-atmega324-modbus-x3-gateway.kicad_pcb (2018-09-20)

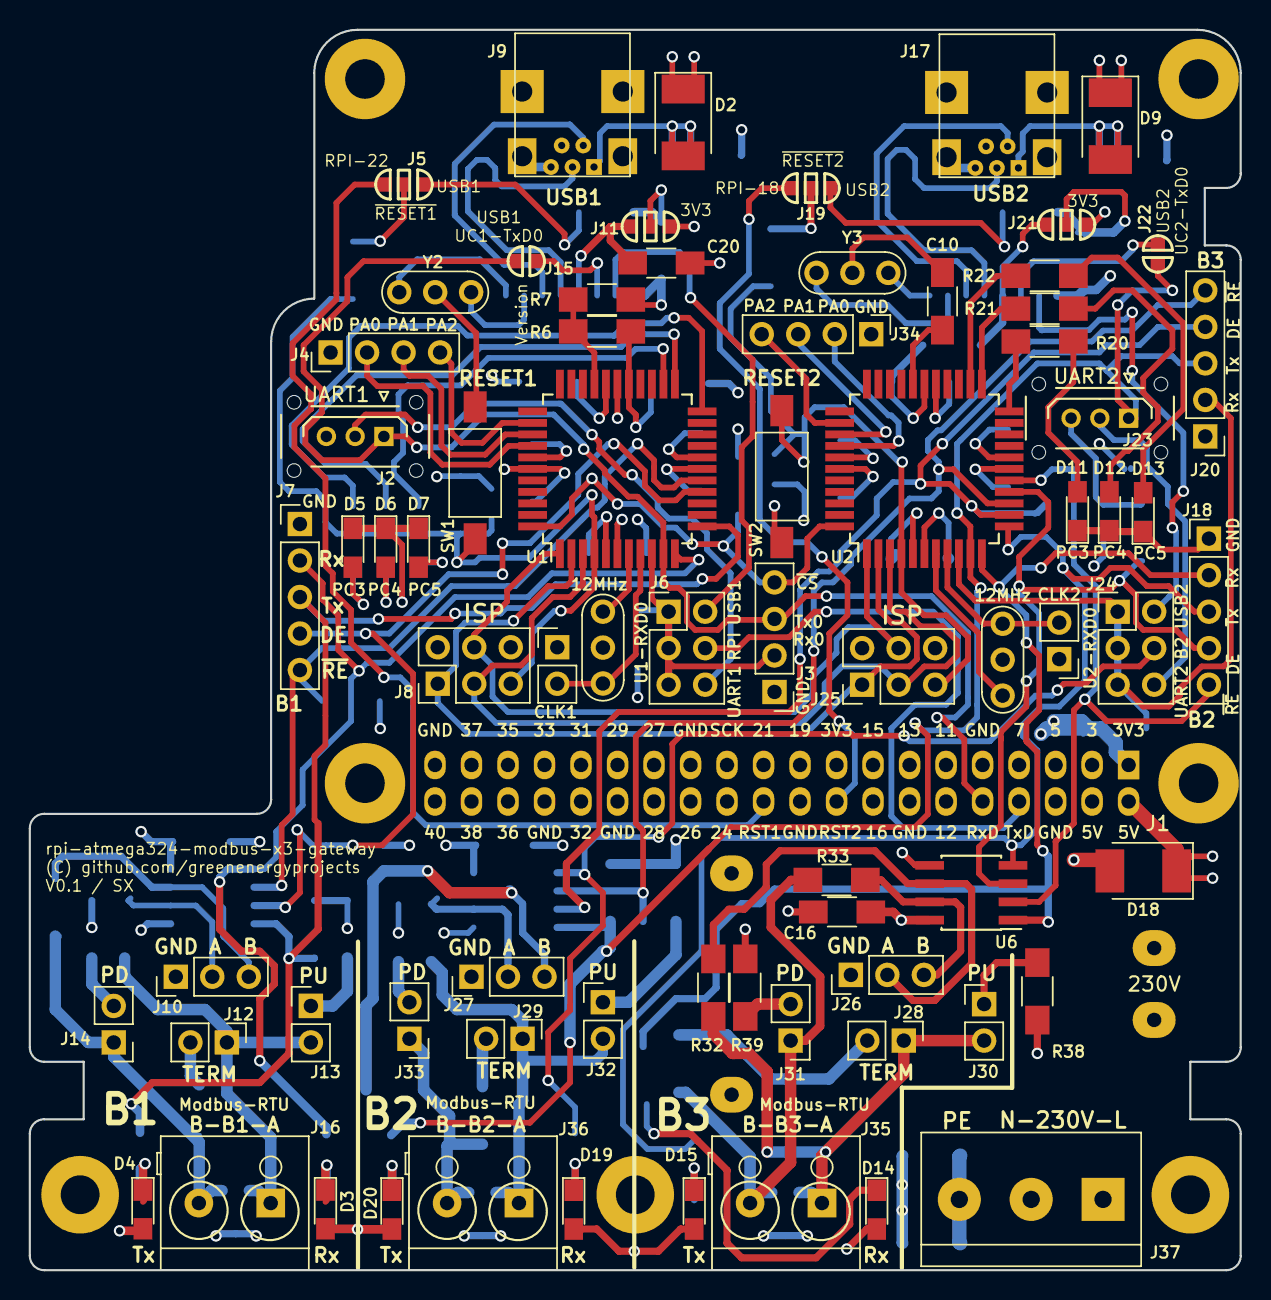
[picture p18: board rpi-atmega324-modbus-x3-gateway.kicad_pcb from above]

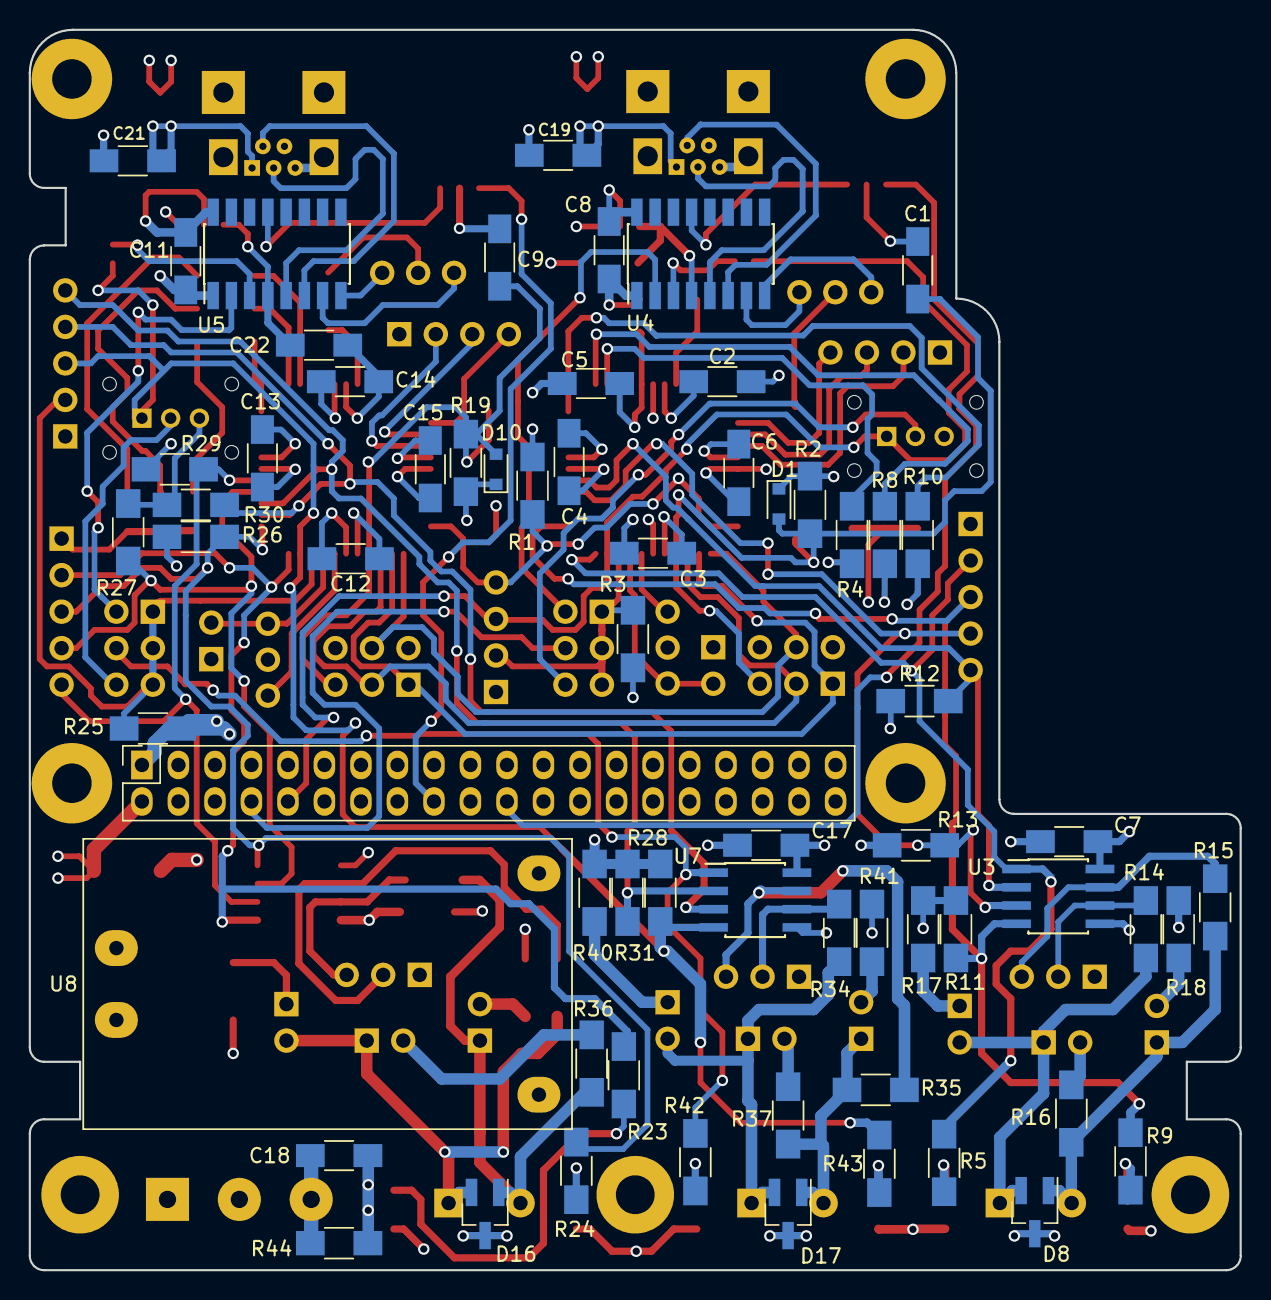
[picture p19: board rpi-atmega324-modbus-x3-gateway.kicad_pcb from below]

Board: 4 copper layers, 84.2 x 86.3 mm, 139 parts (64 on the bottom side), 107 nets.

Parts:
C1, C2, C3, C4, C5, C6, C7, C8, C9, C10, C11, C12, C13, C14, C15, C16, C17, C18, C19, C20, C21, C22: 100n; C_1206_HandSoldering
D1, D10: D_Schottky; D_0805
D2, D9, D18: D_Schottky; D_2114
D3, D4, D5, D6, D7, D11, D12, D13, D14, D15, D19, D20: LED; LED_0805_HandSoldering
D8, D16, D17: D_TVS_x2_AAC; SOT-23_Handsoldering
J1: Raspberry_Pi_2+; Raspberry-PI
J2, J23: UART-Harwin3; Harwin_LTek-Male_03x2.00mm_Straight_StrainRelief
J3, J4, J34: Conn_01x04; Pin_Header_Straight_1x04_Pitch2.54mm
J5, J11, J19, J21: SOLDERBRDIGE-3; SOLDER-JUMPER_2-WAY
J6, J24: Conn_02x03_Odd_Even; Pin_Header_Straight_2x03_Pitch2.54mm
J7, J18, J20: Conn_01x05; Pin_Header_Straight_1x05_Pitch2.54mm
J8, J25: Atmega-ISP-6; Pin_Header_Straight_2x03_Pitch2.54mm
J9, J17: PRJ_USB_MINI; USB_Mini-B-THT
J10, J26, J27: Conn_01x03; Pin_Header_Straight_1x03_Pitch2.54mm
J12, J13, J14, J28, J29, J30, J31, J32, J33, J38, J39: Conn_01x02; Pin_Header_Straight_1x02_Pitch2.54mm
J15, J22: SOLDERBRDIGE-2; SOLDER-JUMPER_1-WAY
J16, J35, J36: Screw_Terminal_01x02; Terminalblock-2x-5mm
J37: Screw_Terminal_01x03; Terminalblock-3x-5mm
R1, R2, R3, R11, R12, R13, R19, R25, R26, R27, R28, R29, R30, R31: 47K; R_1206_HandSoldering
R4, R5, R8, R9, R10, R20, R21, R22, R23, R24, R42, R43: 560R; R_1206_HandSoldering
R6: 10K; R_1206_HandSoldering
R7: 100R; R_1206_HandSoldering
R14, R15, R32, R33, R34, R35: 10R; R_1206_HandSoldering
R16, R36, R37: 150R; R_1206_HandSoldering
R17, R18, R38, R39, R40, R41: 330R; R_1206_HandSoldering
R44: 100k; R_1206_HandSoldering
SW1, SW2: SW_Push; SW_SPST_FSMSM
U1: PRJ-UC1-ATMEGA324P-20AU; TQFP-44_10x10mm_Pitch0.8mm_Handsolded
U2: PRJ-UC2-ATMEGA324P-20AU; TQFP-44_10x10mm_Pitch0.8mm_Handsolded
U3, U6, U7: SN65HVD11; SOIC-8_3.9x4.9mm_Pitch1.27mm_Handsolded
U4, U5: CH340G; SOIC-16_3.9x9.9mm_Pitch1.27mm_HANDSOLDERED
U8: HLK-5M05; HLK_5M05
Y1, Y2, Y3, Y4: 12MHz; Resonator-3pin_w7.0mm_h2.5mm

Connections:
+3V3: C3.1, C4.1, C5.1, C6.1, C7.2, C12.1, C13.1, C14.1, C15.1, C16.2, C17.2, D1.1, D3.2, D4.2, D10.1, D14.2, D15.2, D19.2, D20.2, J1.1, J1.17, J8.2, J11.3, J21.3, J25.2, R1.1, R2.1, R3.1, R6.1, R11.1, R12.1, R17.1, R19.1, R25.1, R26.1, R28.1, R29.1, R31.1, R38.2, R40.2, U1.5, U1.17, U1.27, U1.38, U2.5, U2.17, U2.27, U2.38, U3.8, U6.8, U7.8
+5V: D2.1, D9.1, D18.1, J1.2, J1.4
/uc1/B1-A: J10.2, R14.2, U3.6
/uc1/B1-B: J10.3, R15.2, U3.7
/uc1/HW-VERSION: R6.2, R7.1, U1.30
/uc1/MISO: J8.1, J25.1, U1.2, U2.2
/uc1/MODBUS1-DE: J7.4, R13.1, U1.15, U3.3
/uc1/MOSI: J8.4, J25.4, U1.1, U2.1
/uc1/Modbus1-A: D8.2, J12.1, J13.2, J16.1, R14.1
/uc1/Modbus1-B: D8.1, J14.1, J16.2, R15.1, R16.2
/uc1/RxD: J1.8, J6.4
/uc1/SCK: J8.3, J25.3, U1.3, U2.3
/uc1/TxD: J1.10, J2.1, J3.3, J15.2, U1.10
/uc1/UC1-PA0: J4.2, U1.37
/uc1/UC1-PA1: J4.3, U1.36
/uc1/UC1-PA2: J4.4, U1.35
/uc1/UC1-RST: C1.2, D1.2, J8.5, R2.2, SW1.2, U1.4
/uc1/UC1-RxD0: J3.2, J6.1, J6.3, J6.5, R3.2, U1.9
/uc1/UC1-RxD1: J7.2, R5.2, U1.11, U3.1
/uc1/UC1-TxD1: J7.3, R9.2, R11.2, U1.12, U3.4
/uc1/UC1-XTAL1: J38.2, U1.8, Y1.3
/uc1/USB1-5V: C19.1, D2.2, J9.1
/uc1/USB1-DM: J9.2, U4.6
/uc1/USB1-DP: J9.3, U4.5
/uc1/USB1-RxD: J15.1, U4.3
/uc1/USB1-TxD: J6.2, U4.2
/uc1/USB1_V3: C20.1, J11.1, U4.4
/uc1/~CS~: J3.4, R1.2, U1.44, U2.44
/uc1/~MODBUS1-RE~: J7.5, R12.2, U1.16, U3.2
/uc1/~RESET~: J1.22, J5.1
/uc1/~USB1-DTR~: J5.3, U4.13
/uc2/B2-A: J27.2, R34.2, U7.6
/uc2/B2-B: J27.3, R35.2, U7.7
/uc2/B3-A: J26.2, R32.2, U6.6
/uc2/B3-B: J26.3, R33.2, U6.7
/uc2/MODBUS2-DE: J20.4, R30.1, U2.13, U7.3
/uc2/MODBUS3-DE: J18.4, R27.1, U2.15, U6.3
/uc2/Modbus2-A: D17.2, J29.1, J32.2, J36.1, R34.1
/uc2/Modbus2-B: D17.1, J33.1, J36.2, R35.1, R37.2
/uc2/Modbus3-A: D16.2, J28.1, J30.2, J35.1, R32.1
/uc2/Modbus3-B: D16.1, J31.1, J35.2, R33.1, R36.2
/uc2/UC2-PA0: J34.2, U2.37
/uc2/UC2-PA1: J34.3, U2.36
/uc2/UC2-PA2: J34.4, U2.35
/uc2/UC2-RST: C9.2, D10.2, J25.5, R19.2, SW2.2, U2.4
/uc2/UC2-RxD0: J20.2, J24.1, J24.3, J24.5, R25.2, U2.9
/uc2/UC2-RxD1: J18.2, R23.2, U2.11, U6.1
/uc2/UC2-TxD0: J20.3, J22.1, J23.1, R28.2, R43.2, U2.10, U7.4
/uc2/UC2-TxD1: J18.3, R24.2, R26.2, U2.12, U6.4
/uc2/UC2-XTAL1: J39.2, U2.8, Y4.3
/uc2/USB2-5V: C21.2, D9.2, J17.1
/uc2/USB2-DM: J17.2, U5.6
/uc2/USB2-DP: J17.3, U5.5
/uc2/USB2-RxD: J22.2, U5.3
/uc2/USB2-TxD: J24.2, U5.2
/uc2/USB2_V3: C22.2, J21.1, U5.4
/uc2/~MODBUS2-RE~: J20.5, R31.2, U2.14, U7.2
/uc2/~MODBUS3-RE~: J18.5, R29.2, U2.16, U6.2
/uc2/~RESET~: J1.18, J19.1
/uc2/~USB2-DTR~: J19.3, U5.13
GND: C2.2, C3.2, C4.2, C5.2, C6.2, C7.1, C8.2, C10.2, C11.2, C12.2, C13.2, C14.2, C15.2, C16.1, C17.1, C18.2, C19.2, C20.2, C21.1, C22.1, D5.1, D6.1, D7.1, D8.3, D11.1, D12.1, D13.1, D16.3, D17.3, J1.6, J1.9, J1.14, J1.20, J1.25, J1.30, J1.34, J1.39, J2.3, J3.1, J4.1, J7.1, J8.6, J9.5, J9.6, J10.1, J17.5, J17.6, J18.1, J20.1, J23.3, J25.6, J26.1, J27.1, J34.1, J38.1, J39.1, R7.2, R13.2, R18.2, R27.2, R30.2, R39.2, R41.2, R44.2, SW1.1, SW2.1, U1.6, U1.18, U1.28, U1.39, U2.6, U2.18, U2.28, U2.39, U3.5, U4.1, U5.1, U6.5, U7.5, U8.1, Y1.2, Y2.2, Y3.2, Y4.2
unnamed: C1.1, J5.2
unnamed: C2.1, U1.29
unnamed: C8.1, J11.2, U4.16
unnamed: C9.1, J19.2
unnamed: C10.1, U2.29
unnamed: C11.1, J21.2, U5.16
unnamed: C18.1, J37.3, R44.1
unnamed: D3.1, R5.1
unnamed: D4.1, R9.1
unnamed: D5.2, R10.2
unnamed: D6.2, R8.2
unnamed: D7.2, R4.2
unnamed: D11.2, R20.2
unnamed: D12.2, R21.2
unnamed: D13.2, R22.2
unnamed: D14.1, R23.1
unnamed: D15.1, R24.1
unnamed: D18.2, U8.2
unnamed: D19.1, R42.1
unnamed: D20.1, R43.1
unnamed: J2.2, J6.6
unnamed: J12.2, R16.1
unnamed: J13.1, R17.2
unnamed: J14.2, R18.1
unnamed: J23.2, J24.6
unnamed: J24.4, R42.2, U7.1
unnamed: J28.2, R36.1
unnamed: J29.2, R37.1
unnamed: J30.1, R38.1
unnamed: J31.2, R39.1
unnamed: J32.1, R40.1
unnamed: J33.2, R41.1
unnamed: J37.1, U8.3
unnamed: J37.2, U8.4
unnamed: R4.1, U1.24
unnamed: R8.1, U1.23
unnamed: R10.1, U1.22
unnamed: R20.1, U2.22
unnamed: R21.1, U2.23
unnamed: R22.1, U2.24
unnamed: U1.7, Y1.1
unnamed: U2.7, Y4.1
unnamed: U4.7, Y2.1
unnamed: U4.8, Y2.3
unnamed: U5.7, Y3.1
unnamed: U5.8, Y3.3
