greenenergyprojects/rpi-atmega324-modbus-x3-gateway/software/atmega324p_u2/gateway_u2/src/app.hpp

#ifndef UC2_APP_H_
#define UC2_APP_H_

// declarations

#include "sys.hpp"




// defines

#define APP_VERSION_MAJOR 0
#define APP_VERSION_MINOR 1

#define UC2_APP_MODBUS_DEVICE_ADDRESS 0x81
#define UC2_B2_MODBUS_DEVICE_ADDRESS  3
#define UC2_B3_MODBUS_DEVICE_ADDRESS  1


#define APP_EVENT_PRINTSTATUS   0x01
#define APP_EVENT_1   0x02
#define APP_EVENT_2   0x04
#define APP_EVENT_3   0x08
#define APP_EVENT_4   0x10
#define APP_EVENT_5   0x20
#define APP_EVENT_6   0x40
#define APP_EVENT_DEBUG 0x80


// functions
namespace uc2_app {

    enum ModbusBufferState { 
        Idle = 0,
        RequestInProgress = 1,
        RequestReady = 2,
        SendingRequest = 3,
        WaitForResponse = 4,
        ResponseInProgress = 5,
        ResponseFromUartReady = 6,
        ResponseReadyForSpi = 7,
        SendingResponse = 8,
        RequestForTest = 128
    };

    struct ModbusMeiRequest {
        uint8_t deviceAddress;
        uint8_t functionCode;
        uint8_t meiType;
    };


    struct ModbusBuffer {
        uint8_t errCnt;
        uint8_t frameCnt;
        enum ModbusBufferState state;
        uint8_t size;
        struct ModbusMeiRequest mei;
        uint8_t buffer[];
    };

    struct ModbusBufferLocal {
        uint8_t errCnt;
        uint8_t frameCnt;        
        enum ModbusBufferState state;
        uint8_t size;
        struct ModbusMeiRequest mei;
        uint8_t buffer[128];
    };

    struct ModbusBufferUart0 {
        uint8_t errCnt;
        uint8_t frameCnt;        
        enum ModbusBufferState state;
        uint8_t size;
        struct ModbusMeiRequest mei;
        uint8_t buffer[254];
    };
    
    struct ModbusBufferUart1 {
        uint8_t errCnt;
        uint8_t frameCnt;        
        enum ModbusBufferState state;
        uint8_t size;
        struct ModbusMeiRequest mei;
        uint8_t buffer[254];
    };


    struct ModbusLocal {
        struct ModbusBufferLocal buffer;
    };

    struct ModbusUart0 {
        struct ModbusBufferUart0 buffer;
    };

    struct ModbusUart1 {
        struct ModbusBufferUart1 buffer;
    };


    struct Modbus {
        uint8_t localAddress;
        uint8_t unlocked;
        uint8_t rIndex;
        uint8_t rAddr[2];
        uint8_t addressesLocal[2];
        uint8_t addressesUart0[2];  // B2
        uint8_t addressesUart1[2];  // B3
        uint8_t errCnt;
        uint8_t ocr1a;
        
        struct ModbusLocal local;
        struct ModbusUart0 uart0;
        struct ModbusUart1 uart1;
    };

    struct Spi {
        struct ModbusBuffer *sender;
        uint8_t senderIndex;
        uint8_t timerLed;
        uint8_t cntSent;
        uint8_t toSend;
    };

    struct SysTime {
        uint16_t ms;
        uint8_t sec;
        uint8_t min;
        uint8_t hour;
        uint8_t day;
    };

    struct Debug {
        uint8_t cnt;
        uint8_t index;
        uint8_t buffer[256];
        uint8_t errorIdsIndex;
        uint8_t errorIds[16];
    };

    struct App {
        struct SysTime sysTime;
        uint16_t errCnt;
        struct Modbus modbus;
        struct Spi spi;
        struct Debug debug;
    };

    extern struct App app;

    void init ();
    void main ();

    void task_1ms   ();
    void task_2ms   ();
    void task_4ms   ();
    void task_8ms   ();
    void task_16ms  ();
    void task_32ms  ();
    void task_64ms  ();
    void task_128ms ();

    void uart0ReadyToSent (uint8_t err);
    void uart1ReadyToSent (uint8_t err);
    void handleUart0Byte (int16_t b);
    void handleUart1Byte (int16_t b);
    uint8_t handleSpiByte (uint8_t b);
    void clearDebugBuffer ();
    void pushDebugByte (uint8_t b);

}

#endif  // UC2_APP_H_
