greenenergyprojects/rpi-atmega324-modbus-x3-gateway/software/atmega324p_u1/gateway_u1/src/global.h

#ifndef UC1_GLOBAL_H_INCLUDED
#define UC1_GLOBAL_H_INCLUDED

#define GLOBAL_UC1_SYS_UART0_BITRATE     115200
#define GLOBAL_UC1_SYS_UART1_BITRATE     19200
#define GLOBAL_UC1_SYS_UART0_RECBUFSIZE  16

#endif // UC1_GLOBAL_H_INCLUDED
