greenenergyprojects/rpi-atmega324-modbus-x3-gateway/(commit log)

2018-09-17 PCB design V0.1 complete routed
    [fuc2.sch, rpi-atmega324-modbus-x3-gateway.kicad_pcb, rpi-atmega324-modbus-x3-gateway.sch, uc1.sch, uc2.sch]
2018-09-20 PCB V0.1 Tapeout
    [rpi-atmega324-modbus-x3-gateway.kicad_pcb, rpi-atmega324-modbus-x3-gateway.sch, rpi-atmega324-modbus-x3-gateway_bom.ods, uc1.sch, uc2.sch]
2018-10-07 Update dist/README.md (first print manufactured)
2019-04-07 bootloader buggy but working
    [bootloader_atmega324p.c]
2019-10-04 apparent power/phase power/phase voltage added
2020-03-05 V1.9.0 (fronius meter defect
    [rpi-atmega324-modbus-x3-gateway-2019-12-11-06-38-00.sch, rpi-atmega324-modbus-x3-gateway-2019-12-19-05-55-27.sch, uc1-2019-12-11-06-38-00.sch, uc1-2019-12-19-05-55-27.sch, uc2-2019-12-11-06-38-00.sch, uc2-2019-12-19-05-55-27.sch]
